mrTelnor/wizards-staff/SPEC.md

# Посох мага: техническое задание

Дата: 2026-09-03. Статус: черновик на согласовании.

## 1. Что делаем и зачем

Реквизит для игры в D&D: посох с кристаллом наверху. В кристалле спрятан цветной экран и подсветка. На рукояти кнопки с костями (d2, d4, d6, d8, d10, d12, d20, d100), четыре служебные кнопки и четыре кнопки меню.

Игрок нажимает кнопку кости (один или несколько раз), бьёт посохом об пол, в кристалле мельтешат числа, вспыхивает подсветка, и на экране остаётся результат броска.

Принципы проекта:

1. Максимально просто, но функционально.
2. Всё описано понятным языком, без жаргона там, где без него можно обойтись.
3. Повторить проект сможет любой желающий с паяльником и Arduino IDE.

Уровень исполнителя: паял немного, собирал по туториалам, код правит уверенно.

## 2. Как это работает для игрока

### 2.1. Обычный бросок

1. Нажал кнопку кости, например d20. Экран проснулся, показывает «1d20»: посох взведён. (**Изменено 2026-10-29:** было «кристалл мягко светится». Свечение кристалла теперь не связано со взводом, его включает кнопка «Свет», раздел 2.5.)
2. Ударил посохом об пол. Полторы секунды на экране бегут случайные числа, кольцо светодиодов крутится, пищалка тикает.
3. Экран показывает результат крупно: «17». Подсветка вспыхивает и гаснет до спокойного свечения. Пищалка играет короткий аккорд.
4. Результат висит на экране, пока не взведёшь новый бросок или пока экран не погаснет по таймеру.

### 2.2. Несколько костей

Каждое нажатие той же кнопки добавляет ещё одну такую же кость. Три раза d4: на экране «3d4». Удар. Результат: «3d4: 7», под ним мельче «2 + 1 + 4». Максимум 10 костей в броске; одиннадцатое нажатие возвращает к одной кости, счёт идёт по кругу (**изменено 2026-10-26**, было: на десяти счёт останавливался). Нажатие кнопки другой кости сбрасывает счётчик и взводит одну кость нового типа. Смешивать разные кости в одном броске нельзя, это сделано намеренно, чтобы управление оставалось простым.

### 2.3. Защита от случайных ударов

Удар обрабатывается только если посох взведён. После броска посох разряжается сам. Повторный удар без нажатия кнопки ничего не меняет. Взвод не спадает сам, его снимает только «Сброс» или бросок (**изменено 2026-10-28**, было: через 5 минут без удара посох разряжался сам).

**Изменено 2026-09-18:** было 30 секунд. На игре ход возвращается к игроку через несколько минут, а взводить посох принято заранее, и полминуты не хватало. Риск от длинного взвода небольшой: удар засчитывается только по пачке от десяти переключений датчика за 100 мс, то есть по настоящему стуку, а не по тому, что посох прислонили к стене.

### 2.4. Спокойное состояние

Без броска на экране часы (часы:минуты), дата и значок заряда батареи. Если часы теряли питание и время ещё не пришло с планшета, часы оранжевые и под датой надпись TIME NOT SET; пропадает при подключении планшета (**добавлено 2026-10-29**: время сборки прошивки, которое ставится часам после потери питания, выглядело как настоящее). Результат броска и меню без нажатий через 1,5 минуты сменяются часами (с 2026-10-29 время выбирается в меню). Через 2 минуты без действий экран гаснет, в том числе у взведённого посоха (**изменено 2026-10-28**, было 3 минуты). Свечение кристалла при этом остаётся: его гасит только кнопка «Свет» (**изменено 2026-10-29**, было «экран и подсветка гаснут»). Будят экран: кнопка кости (сразу взводит бросок), любая служебная кнопка или кнопка меню (только будит, своё действие не выполняет), удар по взведённому посоху (сразу бросок и результат), взвод и бросок с планшета.

### 2.5. Служебные кнопки и кнопки меню

**Изменено 2026-10-26.** Было три кнопки: «Экран» (вкл/выкл экрана, долго — настройки), «Сброс» (долго — история), «Свет»; в настройках они же работали как «следующее поле», «минус», «плюс», настраивались время, дата, яркость, звук. Пересмотрено после появления приложения: время и дата приходят с планшета, экран будит любая кнопка, за столом нужны повтор броска и удача/неудача PF2e. Разбор вариантов: `docs/assembly/service-buttons.md`, выбран вариант В плюс отдельные кнопки меню.

Служебные кнопки:

| Кнопка | Короткое нажатие | Долгое нажатие (2 с) |
|---|---|---|
| Сброс | снять взвод, счётчик костей на ноль, вернуться к часам | погасить экран |
| Повтор | взвести тот же бросок, что в прошлый раз (было 2d6 — снова 2d6) | взвести 1d20 с удачей, следующее долгое — с неудачей, и так по кругу (**изменено 2026-10-29**, было «удача → неудача → обычный») |
| Свет | режим подсветки кристалла по кругу: выкл, тускло, ярко | сменить цвет подсветки по кругу; выключенная включается тускло |
| Тихо | звук вкл/выкл | — |

Кнопки меню:

| Кнопка | Вне меню | В меню |
|---|---|---|
| ОК | открыть меню | выбрать пункт, подтвердить значение |
| ◄ | история: бросок назад | пункт назад или значение меньше |
| ► | история: бросок вперёд | пункт вперёд или значение больше |
| Отмена | — | выйти из пункта или меню без сохранения |

- **Свет (решение автора 2026-10-29).** Свечение кристалла имитирует огонь, как при включении: каждый огонёк мерцает сам по себе, переливаясь между двумя цветами палитры. Палитры по кругу: красный — оранжевый, белый — жёлтый, тёмно-зелёный — светло-зелёный, голубой — синий, фиолетовый — тёмно-фиолетовый. Гаснет только кнопкой «Свет», сон экрана и взвод его не трогают. Вспышки бросков идут поверх свечения в любом режиме, после вспышки свечение разгорается снова. Режим и палитра помнятся после выключения тумблера.
- **Удача и неудача.** Для одного d20 посох бросает два и берёт лучший (удача) или худший (неудача). Режим сбрасывается после броска, чтобы не остаться включённым случайно. При взводе на экране видно, что он включён: под «1d20» надпись FORTUNE зелёным или MISFORTUNE красным. На результате крупно итог, снизу мельче оба броска через запятую, без плюса, тем же цветом: «14, 7». Так их не спутать со слагаемыми обычного броска. Долгий «Повтор» взводит 1d20 с удачей из любого состояния, обычный d20 возвращают кнопка кости d20 или «Сброс»; короткий «Повтор» после такого броска взводит обычный 1d20 (решение автора 2026-10-29). На планшет бросок уходит с полем `adv` по плану этапа 2, задача D4.
- **Меню (решения автора 2026-10-29).** Пункты: яркость экрана (20–100 % шагом 20), громкость (тихо, средне, громко), возврат к часам (30 с, 1, 1,5, 2, 3 мин — для результата, истории и самого меню), сон экрана (1, 2, 2,5, 5 мин), тестовый режим d20 (вкл/выкл, на взводе 1d20 пометка TEST), сведения о посохе (прошивка, заряд, число бросков, номер посоха, подтверждено ли время планшетом). Сон всегда дольше возврата к часам: значения, нарушающие это, в правке серые и пропускаются. В списке ◄ ► выбирают пункт, «ОК» открывает его; в правке ◄ ► меняют значение, и оно сразу видно и слышно, «ОК» сохраняет во флеш, «Отмена» возвращает прежнее. Время и дату ставит планшет при подключении. Выход из меню: «Отмена» в списке, «Сброс» или возврат к часам без нажатий, несохранённая правка при этом отменяется (**изменено 2026-10-28**, было 20 секунд; **2026-10-29** — время выхода выбирается в меню).

### 2.6. Питание

- Тумблер на рукояти полностью отключает начинку от аккумулятора. Между играми посох выключен.
- Зарядка через разъём USB-C любым телефонным кабелем. Зарядка работает и при выключенном тумблере.
- Часы идут от своей батарейки-таблетки и не сбиваются при выключении.
- Ожидаемое время работы от одной зарядки со сборкой 4000 мА·ч: 8–10 игровых вечеров по 4 часа (оценка, замерим после сборки).

## 3. Электроника

### 3.1. Мозг: ESP32-C3 SuperMini

Плата размером 22×18 мм, программируется в Arduino IDE на том же языке, что и классические Arduino. Выбрана вместо Arduino Nano по трём причинам:

- работает на 3,3 В, как и дисплей, поэтому не нужен переходник уровней;
- памяти в сотни раз больше, анимации можно делать плавные;
- есть аппаратный генератор случайных чисел, бросок честнее программного.

### 3.2. Схема соединений

Почти всё подключается к двум шинам, поэтому проводов мало.

**Шина I2C** (два провода SDA и SCL): часы DS3231 и два расширителя портов PCF8574. Расширители нужны, потому что ножек у платы 13, а одних кнопок 16. Каждый расширитель даёт 8 входов. Первый полностью занят кнопками костей, второй — 4 служебными кнопками и 4 кнопками меню, запаса нет (**изменено 2026-10-26**, было 3 служебные кнопки и 5 входов в запасе). Понадобится ещё кнопка — третий расширитель на адрес 0x22. Кнопка подключается между входом расширителя и землёй, резисторы не нужны, подтяжка внутри чипа.

**Шина SPI**: только дисплей, 4 сигнальных провода плюс подсветка.

Распиновка ESP32-C3 SuperMini:

| Ножка | Куда идёт | Зачем |
|---|---|---|
| GPIO0 | SDA: часы DS3231, расширители PCF8574 ×2 | I2C, данные |
| GPIO1 | SCL: те же | I2C, такт |
| GPIO3 | делитель напряжения от аккумулятора (100 кОм + 100 кОм) | замер заряда |
| GPIO4 | дисплей SCL (SCK) | SPI, такт |
| GPIO6 | дисплей SDA (MOSI) | SPI, данные |
| GPIO7 | дисплей DC | команда или данные |
| GPIO10 | дисплей RES | сброс дисплея |
| GPIO5 | дисплей BLK | подсветка экрана, ШИМ; ею гасим экран |
| GPIO21 | кольцо WS2812B, вход DIN, через резистор 470 Ом | подсветка кристалла |
| GPIO20 | датчик вибрации SW-420, выход DO | удар посохом |
| GPIO8 | база транзистора S8050 через 470 Ом; транзистор коммутирует электромагнитную пищалку от 5 В, параллельно пищалке диод 1N4148 (**добавлен 2026-10-26**) | звук; в тишине на ножке ноль |
| GPIO9 | не подключается (**изменено 2026-10-26**, было INT расширителей) | кнопка BOOT: ноль при включении переводит плату в режим заливки, поэтому кнопки опрашиваются по шине без INT |
| GPIO2 | не используется | служебная ножка загрузчика, не трогаем |
| 5V, 3V3, GND | питание | см. ниже |

Если на дисплее есть ножка CS, сажаем её на землю: устройство на SPI одно.

Адреса на шине I2C: DS3231 0x68, первый PCF8574 0x20 (кости), второй 0x21 (служебные), адрес задаётся перемычками на модуле.

### 3.3. Питание

```
Аккумулятор 18650, 3,7 В, с платой защиты BMS, разъём XH2.54
   └─► модуль зарядки TP4056 с Type-C и защитой (на выходе OUT напряжение аккумулятора, 3,0–4,2 В)
          ├─ разъём Type-C выведен наружу рукояти
          └─► ТУМБЛЕР ─► повышающий преобразователь MT3608, выставлен на 5,0 В ─► шина 5 В
                             ├─ ESP32-C3, ножка 5V (плата сама делает 3,3 В)
                             ├─ кольцо WS2812B (без конденсатора, см. ниже)
                             └─ пищалка
              ножка 3V3 платы ─► дисплей, часы, расширители, датчик SW-420
```

Почему два модуля, а не один «модуль повербанка» с Type-C и выходом 5 В: платы повербанков (на чипах вроде IP5306) сами отключают выход, если нагрузка меньше примерно 50 мА дольше половины минуты. Посох в режиме сна потребляет как раз около этого, и повербанк выключал бы его посреди игры. Пара TP4056 плюс MT3608 такой самодеятельности не устраивает и стоит столько же.

Всё, что общается с платой сигналами, питается от её 3,3 В, тогда уровни совпадают. Кольцо WS2812B питается от 5 В, сигнал 3,3 В оно понимает на коротком проводе. Если будет мерцать, ставим первый светодиод «жертвенным»: питаем его через диод, чтобы снизить его напряжение до 4,3 В, и уже он передаёт сигнал дальше.

Делитель для замера заряда цепляется к аккумулятору до тумблера. Ток через делитель 20 мкА, батарею он не сажает.

**Изменено 2026-10-29:** конденсатор 1000 мкФ у кольца убран. При включении тумблера пустой конденсатор заряжался из аккумулятора напрямую через MT3608, бросок тока выбивал защиту TP4056, и посох от аккумулятора не включался. Для 12 светодиодов на коротких проводах он не нужен. Если кольцо замерцает на длинных проводах в собранном посохе, конденсатор ставится через резистор 470 Ом с диодом 1N4148, схема в `hardware/wiring.md`, раздел «Питание».

### 3.4. Список компонентов

Цены ориентировочные по Ozon и Wildberries на сентябрь 2026, разброс у продавцов до двух раз.

| № | Что | Что вбивать в поиск | Цена, ₽ |
|---|---|---|---|
| 1 | Плата ESP32-C3 SuperMini | `ESP32-C3 SuperMini` | 250–400 |
| 2 | Дисплей 1,54" IPS 240×240 ST7789 SPI | `дисплей 1.54 ST7789 240x240 SPI IPS` | 500–900 |
| 3 | Модуль часов DS3231 с батарейкой | `DS3231 модуль часов mini` | 150–300 |
| 4 | Расширитель портов PCF8574, 2 шт | `PCF8574 модуль расширения I2C` | 100–200 за шт |
| 5 | Кольцо адресных светодиодов WS2812B, 12 шт | `WS2812B кольцо 12 светодиодов` | 150–300 |
| 6 | Датчик вибрации SW-420 | `SW-420 датчик вибрации модуль` | 80–150 |
| 7 | Пассивная электромагнитная пищалка 12 мм (12085, 3–5 В) | `пассивный зуммер 12085 5V` | 50–100 |
| 7а | Транзистор NPN S8050 или 2N2222 (усилитель для пищалки) | `транзистор S8050 TO-92` | 50–100 за пачку |
| 7б | Диод 1N4148 параллельно пищалке (добавлен 2026-10-26) | `диод 1N4148` | 50 за пачку |
| 7в | Гребёнка «папа» 2,54 мм под шину земли кнопок (добавлена 2026-10-26) | `гребёнка PLS 2.54` | 50 |
| 8 | Модуль зарядки TP4056 с Type-C и защитой | `TP4056 Type-C с защитой` | 50–150 |
| 8а | Повышающий преобразователь MT3608 (3,7 → 5 В, до 2 А) | `MT3608 повышающий преобразователь` | 50–150 |
| 9 | Аккумулятор 18650 3,7 В 4000 мА·ч: две банки в параллель под одной оболочкой, с BMS и разъёмом XH2.54, сборка 66×37×19 мм | `аккумулятор 18650 3.7V 4000 с защитой XH2.54` | 500–900 |
| 10 | Выключатель питания на ток не меньше 2 А: тумблер MTS-102 или крупный ползунковый SS-22F | `тумблер MTS-102`, `ползунковый переключатель 3A` | 50 |
| 11 | Тактовые кнопки 12×12 мм с колпачками, 16 шт (набор; было 11 до 2026-10-26) | `кнопки тактовые 12x12 набор колпачки` | 150–300 |
| 12 | Резисторы 100 кОм ×2, 470 Ом ×2 (кольцо и база транзистора); конденсатор 1000 мкФ 16 В — не ставится с 2026-10-29, нужен только как запасной вариант, см. 3.3 | `набор резисторов`, `конденсатор 1000 мкФ` | 100–200 |
| 13 | Ответный разъём к аккумулятору, 2 pin с проводами, того же типа, что на аккумуляторе | `SM2.54 2pin разъём с проводом` или `XH2.54 2pin разъём с проводом` | 50 |
| 14 | Монтажный провод 0,2–0,3 мм², термоусадка, провода Dupont | `провод МГТФ`, `dupont провода набор` | 200–300 |
| 15 | Макетная плата для прототипа | `breadboard 830` | 200–300 |

Итого электроника: примерно 3–5 тысяч рублей.

Инструменты (есть в наличии): паяльник 40–60 Вт с тонким жалом, припой с флюсом, мультиметр, термоклей, бокорезы, кабель USB-C, компьютер с Arduino IDE.

## 4. Корпус

**Изменено 2026-10-22: корпус делается без 3D-печати**, из ПВХ-труб и фитингов ручным инструментом. Везде, где ниже сказано «напечатанная деталь», берётся вариант без принтера: оправа — ПВХ-муфта 25→32 мм (раздел 4.3), рукоять — отрезок ПВХ-трубы 50 мм с двумя переходниками 50→25 (раздел 4.5). Картридж под дисплей и кольцо (раздел 4.2) без печати ещё не продуман, решается в задаче 14 плана. Фотополимерная печать кристалла отпадает, остаётся заливка шара в молд.

### 4.1. Общая компоновка

Посох состоит из трёх частей, соединённых проводами внутри трубы.

```
   ┌─────────┐
   │ КРИСТАЛЛ│  экран + кольцо светодиодов внутри, открыт снизу
   └────┬────┘
   ┌────┴────┐
   │ ОПРАВА  │  держит кристалл, провода уходят в трубу
   └────┬────┘
        │
        │       стержень: ПВХ-труба 25 мм, длина 120–150 см
        │
   ┌────┴────┐
   │ РУКОЯТЬ │  муфта на трубе: вся электроника, 16 кнопок, тумблер, Type-C
   └────┬────┘
        │
        │
       ═╧═      резиновый наконечник
```

Общая длина подбирается под рост: верх кристалла на уровне глаз или чуть выше. Рукоять ставится там, где кисть лежит при ударе об пол, обычно на высоте груди. Кнопки под большим пальцем.

### 4.2. Кристалл

Кристалл полый, открытый снизу. Электроника в смолу не заливается: залитое не починить, а тепло застывающей эпоксидки и её усадка могут погубить дисплей.

Два способа изготовления, на выбор:

- **Фотополимерная печать** прозрачной смолой: стенка 2–3 мм, полость внутри, отверстие снизу под картридж. Самый простой и ремонтопригодный путь. Передняя грань плоская и полируется до прозрачности, остальные грани можно оставить матовыми, они будут рассеивать подсветку.
- **Заливка эпоксидкой в силиконовый молд.** Полость делается вставкой: в молд до заливки ставится напечатанный или вырезанный сердечник, смазанный разделителем, после застывания сердечник вынимается.

**Выбрано (2026-09-11): шар 120 мм**, куплен силиконовый молд «хрустальный шар 120 мм». Кристалл становится хрустальным шаром, как у гадалки. Что из этого следует:

- **Шар должен быть полым, стенка 8–12 мм.** Сплошной шар 120 мм это около 900 г смолы на макушке полутораметрового посоха, слишком тяжело и опасно при заливке: большая масса эпоксидки перегревается, желтеет и трескается. Полый шар со стенкой 10 мм весит около 450 г, заливается в один-два слоя. Внутренняя полость около 100 мм в диаметре, картридж с дисплеем и кольцом в неё входит свободно.
- **Отверстие снизу под картридж не меньше 50 мм.** У молда для шара заливочное отверстие обычно 20–30 мм. Его нужно расширить до 50–55 мм острым ножом, силикон режется легко. Расширенное отверстие оказывается внизу шара и скрывается в оправе.
- **Сердечник для полости:** шар диаметром 100 мм из пенопласта (продаётся как заготовка для рукоделия), обтянутый пищевой плёнкой или скотчем и смазанный разделителем, на ножке диаметром 50 мм, которая выходит через отверстие молда и центрирует сердечник. После застывания пенопласт вынимается через отверстие: ломается пальцами или растворяется ацетоном.
- **Оптика.** Толстая стенка с воздухом внутри слегка увеличивает изображение, как лупа, цифры читаются. Сплошной шар был бы сильной линзой и искажал бы экран, ещё одна причина делать полость. Дисплей стоит вплотную к передней стенке, отступ 3–5 мм.
- **Смола:** эпоксидка для заливки «ювелирная» или «для толстых слоёв», прозрачная, с медленным отвердителем. Заливать в два слоя по половине, каждый до 15–20 мм толщиной, между слоями сутки. Готовый шар шлифуется по шву молда и полируется.

Прежний вариант, гранёный кристалл 8–10 см печатью или заливкой, остаётся запасным.

Внутри кристалла картридж: напечатанная рамка, в которой стоит дисплей лицом к передней стенке, а под ним кольцо светодиодов, светящее вверх в толщу шара. Для шара картридж проектируется под полость 100 мм и отверстие 50 мм: дисплей на высоте центра шара, кольцо у основания. Картридж вставляется снизу через оправу и фиксируется винтом или защёлкой. Провода от картриджа: 7 на дисплей (5 сигнальных плюс питание) и 3 на кольцо.

### 4.3. Оправа

Напечатанная деталь: сверху чаша под шар (или «когти», как у настоящих посохов), которая закрывает отверстие 50 мм и держит шар за нижнюю треть, снизу пробка в трубу. Шар в чаше сажается на прозрачный силиконовый герметик или эпоксидку, чтобы не вылетел при ударе об пол. Сквозное отверстие под провода. Если печати нет, роль оправы играет ПВХ-муфта 25→32 мм, обмотанная шпагатом или кожей.

### 4.4. Стержень

Жёсткая ПВХ-труба 25 мм (электромонтажная гладкая) длиной 120–150 см. Легко пилится, сверлится, красится. Декор: обмотка шпагатом, кожей, шпаклёвка под кору дерева, покраска. Альтернативы: алюминиевая трубка (тяжелее, звонче стук) или деревянная палка с высверленным каналом (красиво, но сверлить сквозной канал полтора метра трудно).

Внизу резиновый наконечник для трости под диаметр трубы: стук глухой, пол целый, датчик вибрации всё равно ловит удар через трубу.

### 4.5. Рукоять

Напечатанный корпус из двух половинок, длина 20–24 см, диаметр 50–55 мм. Он не надевается на трубу, а заменяет её отрезок: труба в этом месте разрезана, её концы входят в гнёзда корпуса сверху и снизу на глубину 30 мм, половинки стягиваются винтами. Так внутри остаётся место под аккумуляторную сборку 66×37×19 мм: рядом с целой трубой 25 мм она не поместилась бы. Посох в этом месте получается толстым, это осознанный выбор в пользу ёмкости. В корпусе:

- 8 отверстий под кнопки костей в ряд, рядом подпись (d2, d4, ...) или цветные колпачки;
- 4 отверстия под служебные кнопки, отдельной группой, чтобы не путать с костями;
- 4 отверстия под кнопки меню крестом: ОК, ◄, ►, Отмена (**изменено 2026-10-26**, кнопок меню не было);
- окно под разъём Type-C с заглушкой;
- вырез под тумблер, утопленный, чтобы не задеть в игре;
- внутри ложе под аккумуляторную сборку 66×37×19 мм и полки под платы.

Без принтера: отрезок ПВХ-трубы 50 мм с двумя переходниками 50→25 по концам, отверстия сверлятся, платы садятся на термоклей.

Датчик вибрации крепится внутри рукояти жёстко к трубе, вибрация от удара доходит по трубе. Чувствительность настраивается винтом на модуле.

## 5. Прошивка

### 5.1. Состояния

```
   ┌──────────┐  кнопка кости   ┌──────────┐    удар     ┌──────────┐
   │ ОЖИДАНИЕ ├─────────────────►│ ВЗВЕДЁН  ├────────────►│  БРОСОК  │
   │  (часы)  │◄─────────────────┤  «3d6»   │             │ анимация │
   └────┬─────┘  5 мин без удара └──────────┘             └────┬─────┘
        │        или «Сброс»                                   │
        │ 3 мин                                                ▼
        ▼                                                ┌──────────┐
   ┌──────────┐  любая кнопка                            │РЕЗУЛЬТАТ │
   │   СОН    ├──────────────► в ОЖИДАНИЕ или ВЗВЕДЁН    │ «3d6: 11»│
   │экран выкл│                                          └──────────┘
   └──────────┘                        РЕЗУЛЬТАТ ──3 мин──► СОН
                                       РЕЗУЛЬТАТ ──кнопка кости──► ВЗВЕДЁН

   «ОК» из ОЖИДАНИЯ или РЕЗУЛЬТАТА ──► МЕНЮ ──«Отмена»──► обратно
```

### 5.2. Правила

- **Кнопки.** Дребезг гасится программно: нажатие засчитывается, если кнопка держится 30 мс. Долгое нажатие: 2 секунды.
- **Удар.** Датчик SW-420 даёт короткий импульс. Учитываем его только в состоянии ВЗВЕДЁН и не раньше чем через 300 мс после последнего нажатия кнопки, чтобы само нажатие не сработало как удар. После броска датчик игнорируется до нового взвода.
- **Случайное число.** Аппаратный генератор ESP32. Для NdX бросаем N раз отдельно, суммируем и запоминаем каждую кость. d100 даёт 1–100.
- **Анимация броска.** Полторы секунды: числа на экране меняются сначала быстро, потом всё медленнее и останавливаются на результате. Кольцо крутится «бегущим огоньком» с той же скоростью. Пищалка тикает на каждой смене числа, в конце короткий аккорд. **Изменено 2026-10-22:** экран повторяет барабан из приложения на планшете — 1,1 секунды, суммы выезжают снизу вверх, бледные, пока крутится, слагаемые спрятаны до остановки.
- **Результат.** Крупно сумма. Если костей больше одной, сверху «3d6», снизу мельче слагаемые. Для одного d20 дополнительно: 20 подсвечивается золотым и кольцо вспыхивает, 1 подсвечивается красным.
- **История.** Последние 20 бросков из истории во флеш, списком по 4 на экран, свежие сверху: время, что бросали, итог, под ним мелко слагаемые. Переживают выключение тумблера. ◄ с любого экрана открывает историю, дальше ◄ и ► двигают выделение по одной строке (◄ к старым, ► к новым), выбранная строка на тёмно-синем фоне, список сдвигается вслед за выделением по одной строке; ► на самом свежем броске, «Отмена», «Сброс» или 1,5 минуты без нажатий возвращают на взвод или к часам, взвод не снимается (**изменено 2026-10-29**, было: 5 бросков в оперативной памяти по одному, только с экрана часов, терялись при выключении; до 2026-10-26 — по долгому «Сброс»).
- **Часы.** Читаем DS3231 раз в секунду. Настройка через меню.
- **Заряд.** Читаем напряжение аккумулятора раз в 10 секунд через делитель, переводим в проценты: 4,2 В это 100 %, 3,3 В это 0 %. Значок батареи в углу экрана. Ниже 5 % значок мигает.
- **Сон.** Подсветка экрана гаснет через 2 минуты без действий (**изменено 2026-10-28**, было 3). Кольцо сон не трогает: свечение гасит только «Свет» (**изменено 2026-10-29**, раньше гасло и кольцо). Плата продолжает слушать кнопки. Глубокий сон платы с пробуждением по кнопке: возможное улучшение позже, если автономности не хватит.

### 5.3. Среда и библиотеки

- Arduino IDE 2.x, пакет плат «esp32 by Espressif», плата «ESP32C3 Dev Module».
- Дисплей: Adafruit GFX + Adafruit ST7789.
- Часы: RTClib (Adafruit).
- Кольцо: Adafruit NeoPixel.
- Расширители: Adafruit PCF8574.

Код разбивается на небольшие файлы по смыслу: настройки ножек, кнопки, экран, кости, подсветка, звук, главный цикл. Каждый файл делает одно дело, каждая функция снабжена комментарием, что она делает и зачем.

## 6. Порядок работы

1. Закупка компонентов по списку из раздела 3.4.
2. Сборка на макетной плате проводами Dupont, без пайки. Проверка каждого модуля отдельно: дисплей, часы, кольцо, кнопки, датчик, пищалка.
3. Прошивка: сначала минимальная (кнопка, удар, число), потом анимация, часы, настройки, история.
4. Тесты на столе: серия из 100 бросков d6 и d20, проверка равномерности «на глаз», проверка ложных срабатываний датчика.
5. Изготовление корпуса: кристалл, оправа, рукоять, труба.
6. Пайка начисто, укладка в посох, финальная проверка.
7. Замер времени работы от одной зарядки, запись в журнал.

## 7. Что осознанно не делаем

- Смешанные броски (d6 + d4 в одном ударе).
- Модификаторы к броску (+3 и подобное).
- Wi-Fi, Bluetooth, приложение на телефоне.
- Голос и запись звуков: только пищалка.
- Кнопка в наконечнике и акселерометр: выбран датчик вибрации как самый простой.

## 7а. Этап 2: связь с планшетом и приложение

**Изменено 2026-09-19:** раздел назывался «Идеи на потом (этап 2, после запуска посоха)» и описывал всё нижеследующее как незапланированное. С 2026-09-17 этап 2 идёт параллельно основной сборке, наполовину сделан, и цифры в старой редакции успели устареть. Рабочий план этапа лежит в `docs/ПЛАН-APP.md`.

### Решения

- **Связь с планшетом по Bluetooth.** У ESP32-C3 Bluetooth встроен, железо докупать не нужно. Посох отдаёт события бросков и заряд, принимает время и настройки. Расход батареи при подключённом планшете плюс 10–15 мА.
- **Приложение: сразу APK** (решение от 2026-09-08), без промежуточной веб-страницы. Цель: Android и HarmonyOS до версии 4 включительно (они запускают APK). HarmonyOS NEXT (5 и новее) APK не поддерживает, для неё потребовалось бы отдельное приложение на ArkTS; отдельный пункт «если понадобится». Web Bluetooth страница остаётся необязательной страховкой для отладки протокола.
- **Основное устройство — планшет** HUAWEI MatePad SE 11 (HarmonyOS 2.0, то есть Android 10, без сервисов Google). Проверка на телефонах отложена до готовности листа персонажа (решение от 2026-09-19): основная разработка — посох и планшет.
- **Защита связи PIN-кодом** (решение от 2026-09-18): четыре цифры, без PIN посох не отвечает и сам разрывает связь через 10 секунд, одновременное подключение только одно, при подборе нарастающая блокировка. PIN живёт во флеш посоха и меняется из приложения.
- **Обновление прошивки по Bluetooth** (решение от 2026-09-18) выделено в отдельный этап, который делается после сборки посоха. Причина: наружу рукояти выведен только разъём зарядки, свой USB платы остаётся внутри, и после закрытия рукояти обновление по воздуху — единственный способ что-то поправить.
- **Функции приложения:** полная история бросков с подписями, синхронизация времени с планшета, листы персонажей D&D и Pathfinder, модификаторы к броскам, **переназначение кнопок посоха**: любой из 8 кнопок задаётся число граней (например d3 или d1000), служебным кнопкам назначаются другие действия (например «перебросить последний»).
- **Следствие для корпуса:** колпачки кнопок цветные, без цифр, чтобы переназначение не спорило с надписями; соответствие цвета кости показывать на экране при нажатии.

### Что уже работает (прошивка 0.4.2 на 2026-09-19)

- Посох виден как `WizardsStaff`, поднимает сервис Nordic UART и стандартный Battery Service. Сообщения — по строке JSON на каждое.
- Команды: `info`, `time`, `arm`, `disarm`, `roll`, `hist`, `map`.
- История бросков во флеш: кольцевой файл в LittleFS на 1500 записей. Номера бросков сквозные и переживают выключение, у посоха есть постоянный номер `staffId`. Приложение догружает пропущенное командой `hist`, порциями по 50 записей.
- Таблица костей по кнопкам хранится во флеш и меняется командой `map`.
- Кости до d1000, как и обещано в старой редакции этого раздела.
- Служебные сообщения посоха приходят в приложение единым журналом: время, модуль, уровень, текст.
- Приложение (Kotlin, Compose, minSdk 29): подключение, лента бросков, экран логов с отправкой команд и сохранением в файл.

### Что осталось

Защита PIN-кодом, база бросков в приложении с подписями, настройки посоха, статистика, листы персонажей и действия, преимущество и помеха, таймер хода, обновление прошивки по Bluetooth. Подробности и порядок — в `docs/ПЛАН-APP.md`.

## 8. Структура репозитория

```
wizards-staff/
  README.md          обзор проекта, как играть, как повторить
  SPEC.md            этот документ
  JOURNAL.md         журнал сборки: что сделали, что не заработало, как починили
  firmware/          код для Arduino IDE, скетч wizards_staff
  hardware/          спецификация компонентов (bom.md), распиновка (wiring.md), схема, фото макета
  enclosure/         размеры, модели для печати (STL), фото корпуса
  docs/              служебные материалы, в git не входят
```
