mrTelnor/wizards-staff/hardware/bom.md

# Посох мага: закупки

Ссылки и цены по факту покупки. Ориентиры и поисковые слова: [SPEC.md](../SPEC.md), раздел 3.4.

Статусы: не заказано, заказано, получено.

## Электроника

| № | Что | Где куплено (ссылка) | Кол-во | Цена, ₽ | Статус | Проверить |
|---|---|---|---|---|---|---|
| 1 | ESP32-C3 SuperMini Wi-Fi Bluetooth (первый лот https://ozon.ru/t/5DRsU0M закончился) | https://ozon.ru/t/qtwUUhx | 1 | | получено | мигалка залита, Serial работает; заводская прошивка уходила в цикл сброса, заливать первый раз из режима BOOT |
| 2 | Дисплей 1,54" IPS 240×240, модуль ST7789 Ver 1.1, 8 pin: GND VCC SCL SDA RST DC CS BL | https://ozon.ru/t/l1xMlUN | 1 | | получено | гребёнка в комплекте, припаять самому |
| 3 | Часы DS3231 GSMIN | https://ozon.ru/t/wEVthoS | 1 | | получено | проверить, есть ли батарейка, иначе купить CR2032 |
| 4 | Расширитель PCF8574T I2C | https://ozon.ru/t/QWX4wPA | **2** | | получено | перемычки адреса A0–A2 на плате |
| 5 | Кольцо WS2812B 12 LED | https://ozon.ru/t/8Mj053o | 1 | | получено | припаять 3 провода: 5V, GND, DI (не DO) |
| 6 | Датчик вибрации SW-420 | https://ozon.ru/t/D4hXyOb | 1 | | получено | |
| 7 | Пассивный зуммер 12×8,5 мм, 42 Ом, 3–12 В, 10 шт | https://ozon.ru/t/fBTrUhP | 1 упак. | | получено | |
| 7а | Транзистор NPN S8050D, корпус TO-92 | https://ozon.ru/t/j70qy2p | 1 (пачка) | | получено | резистор 470 Ом в базу уже есть в позиции 12б |
| 8 | Модуль зарядки TP4056 Type-C с защитой | https://ozon.ru/t/9oYLj16 | 1 | | получено | |
| 8а | Повышающий преобразователь MT3608 | https://ozon.ru/t/9oYy1zH | 1 | | получено | |
| 9 | Аккумулятор 18650 3,7 В 4000 мА·ч, две банки, BMS, XH2.54 | https://ozon.ru/t/hiSuw5o | 1 | | получено | мультиметром на разъёме: 3,5–4,0 В, плюс на красном |
| 10 | Выключатель питания (по характеристикам тумблер 6 А, отверстие 6 мм; в названии «кулисный») | https://ozon.ru/t/5DRsDMw | 1 | | получено | проверено 2026-10-22: тумблер, двухпозиционный; отверстие в рукояти 6 мм (по характеристикам, при сверлении сверить с гайкой) |
| 11 | Тактовые кнопки 12×12×7,3 мм, 25 шт + 25 колпачков 5 цветов | https://ozon.ru/t/6lAzRP5 | 1 упак. | | получено | проверено 2026-10-22: без фиксации, возвращаются сами |
| 12а | Резистор 100 кОм 0,25 Вт 1 %, 10 шт | https://ozon.ru/t/mUrBULR | 1 упак. | | получено | |
| 12б | Резистор 470 Ом 0,25 Вт 1 %, 10 шт | https://ozon.ru/t/mUrBOjf | 1 упак. | | получено | |
| 12в | Конденсатор 1000 мкФ 16 В, 3 шт | https://ozon.ru/t/mUrImPE | 1 упак. | | получено | у кольца не ставится (2026-10-29): выбивал защиту TP4056 при включении; запасной вариант через 470 Ом и 1N4148, hardware/wiring.md |
| 13 | Кабель JST XH2.54 2 pin 10 см + разъём на плату, 2 шт | https://ozon.ru/t/WcpKc4E | 1 упак. | | получено | |
| 14а | Dupont 20 см, 3 вида по 40 шт | https://ozon.ru/t/EI26bNG | 1 упак. | | получено | |
| 14б | Провод МГШВ 0,35 мм², 7 цветов, 21 м | https://ozon.ru/t/J5eNutV | 1 набор | | получено | |
| 14в | Провод ПВАМ 0,75 мм², 2×5 м | https://ozon.ru/t/dwFqdxz | 1 упак. | | получено | |
| 14г | Термоусадка 2, 3 и 6–8 мм | | | | получено | |
| 15 | Макетная плата 400 точек, 3 шт | https://ozon.ru/t/l1xLITL | 3 | | получено | |
| 16 | Диод 1N4148, 10 шт | https://ozon.ru/t/D4JkHjr | 1 упак. | | получено | параллельно зуммеру, полоска (катод) к 5V |
| 17 | Гребёнка «папа» 2,54 мм PLS-40, прямая, 40 штырей, 10 шт | https://ozon.ru/t/IYwbvUC | 1 упак. | | получено | шины питания и земли: GND 30, 5 В 7, 3,3 В 7 штырей (hardware/wiring.md) |

## Корпус (покупается на этапе C, без 3D-печати — решение 2026-10-22)

| Что | Где | Цена, ₽ | Статус |
|---|---|---|---|
| ПВХ-труба 25 мм, 1,5 м | | | не заказано |
| Рукоять без печати: отрезок ПВХ-трубы 50 мм около 25 см и два переходника 50→25, подобрать по факту (SPEC, раздел 4.5) | | | не заказано |
| Оправа без печати: ПВХ-муфта 25→32 мм (SPEC, раздел 4.3) | | | не заказано |
| Резиновый наконечник для трости 25 мм | | | не заказано |
| Силиконовый молд «хрустальный шар» 120 мм | https://ozon.ru/t/5DlQLcc | | заказано |
| Эпоксидная смола прозрачная для заливки толстых слоёв, около 600 г с отвердителем | | | не заказано |
| Шар из пенопласта 100 мм (сердечник для полости) | | | не заказано |
| Разделитель для силиконовых форм (или вазелин, или восковой спрей) | | | не заказано |
| Наждачка 400–2000 и полировальная паста для шва шара | | | не заказано |
| Винты М3 ×4 для рукояти | | | не заказано |
