mrTelnor/wizards-staff/hardware/wiring.md

# Распиновка и подключение модулей

Все номера ножек продублированы в `firmware/wizards_staff/config.h`. Если меняется подключение, меняется и он.

Полная схема соединений в картинке: [schematic/wiring.svg](schematic/wiring.svg). Отдельно блок питания: [schematic/power.svg](schematic/power.svg). Земля (GND) у всех модулей общая, это первый провод к каждому модулю.

## Ножки ESP32-C3 SuperMini

Подписи ножек напечатаны на нижней стороне платы. Со стороны подписей, USB вверх: левый ряд `5V, G, 3.3, 4, 3, 2, 1, 0`, правый ряд `5, 6, 7, 8, 9, 10, 20, 21`. На макетке плата лежит чипом вверх, поэтому ряды меняются местами: ряд `5V` оказывается справа. Так же плата нарисована на схемах: снизу, как на фото.

| Ножка | Куда идёт | Зачем |
|---|---|---|
| GPIO0 | SDA: цепочка PCF8574 №1 → PCF8574 №2 → часы DS3231 | I2C, данные |
| GPIO1 | SCL: та же цепочка | I2C, такт |
| GPIO3 | делитель напряжения от аккумулятора (100 кОм + 100 кОм) | замер заряда |
| GPIO4 | дисплей SCL (SCK) | SPI, такт |
| GPIO5 | дисплей BL (BLK) | подсветка экрана, ШИМ |
| GPIO6 | дисплей SDA (MOSI) | SPI, данные |
| GPIO7 | дисплей DC | команда или данные |
| GPIO8 | база транзистора S8050 через 470 Ом, транзистор коммутирует пищалку от 5 В | звук; на этой же ножке синий светодиод платы, в тишине он горит |
| GPIO9 | не подключать | кнопка BOOT платы: ноль на ней при включении переводит плату в режим заливки. Поэтому INT расширителей сюда не ведём (решение 2026-10-26), кнопки опрашиваются по шине |
| GPIO10 | дисплей RST (RES) | сброс дисплея |
| GPIO20 | датчик вибрации SW-420, выход DO | удар посохом |
| GPIO21 | кольцо WS2812B, вход DI, через резистор 470 Ом | подсветка кристалла |
| GPIO2 | не используется | служебная ножка загрузчика, не трогаем |
| 5V, 3V3, GND | питание | см. ниже |

Адреса на шине I2C: DS3231 0x68, первый PCF8574 0x20 (кости), второй 0x21 (служебные и меню). Адрес задаётся перемычками A0–A2 на модуле. Чипы на наших модулях — PCF8574T (проверено 2026-10-26); у PCF8574AT адреса были бы 0x38 и 0x39.

## Дисплей 1,54" ST7789

На плате модуля 8 контактов. Устройство на SPI одно, поэтому CS сажаем на землю.

| Дисплей | ESP32-C3 |
|---|---|
| GND | GND |
| VCC | 3V3 |
| SCL | GPIO4 |
| SDA | GPIO6 |
| RST | GPIO10 |
| DC | GPIO7 |
| CS | GND |
| BL | GPIO5 |

## Расширители PCF8574 и кнопки

Шина I2C собрана цепочкой (решение 2026-10-27): плата → расширитель №1 → расширитель №2 → часы. У модуля PCF8574 с одного края входная гребёнка, с другого выходное гнездо, по которому те же GND, VCC, SDA, SCL и INT идут дальше. К плате провода идут только от входа первого расширителя, остальные модули питаются и общаются через него.

| Вход PCF8574 №1 (0x20, кости) | ESP32-C3 |
|---|---|
| GND | GND |
| VCC | 3V3 |
| SDA | GPIO0 |
| SCL | GPIO1 |
| INT | не подключать |

Расширитель №2 (0x21) втыкается входной гребёнкой в выходное гнездо №1. Часы подключаются к выходному гнезду №2, см. раздел «Часы DS3231».

На каждом модуле стоят подтяжки SDA и SCL по 1 кОм (резисторы «102»); с двумя модулями и часами шина работает. Если расширитель начнёт пропадать, выпаять подтяжки на модуле №2.

Если отвалится разъём между модулями, пропадёт всё, что стоит за ним: вынули №2 — пропали и часы.

Кнопка подключается между входом расширителя и GND, резисторы не нужны, подтяжка внутри чипа. Берутся две ножки кнопки по диагонали. Земля всех 16 кнопок идёт на общую шину GND, см. раздел «Шины питания и земли».

| Расширитель | Вход | Кнопка |
|---|---|---|
| 0x20 (кости) | P0 | d2 |
| 0x20 | P1 | d4 |
| 0x20 | P2 | d6 |
| 0x20 | P3 | d8 |
| 0x20 | P4 | d10 |
| 0x20 | P5 | d12 |
| 0x20 | P6 | d20 |
| 0x20 | P7 | d100 |
| 0x21 (служебные и меню) | P0 | Сброс |
| 0x21 | P1 | Повтор |
| 0x21 | P2 | Свет |
| 0x21 | P3 | Тихо |
| 0x21 | P4 | ОК |
| 0x21 | P5 | ◄ Назад |
| 0x21 | P6 | ► Вперёд |
| 0x21 | P7 | Отмена |

Что делает каждая кнопка: SPEC, раздел 2.5.

## Датчик вибрации SW-420

| SW-420 | ESP32-C3 |
|---|---|
| GND | GND |
| VCC | 3V3 |
| DO | GPIO20 |

Чувствительность настраивается винтом на модуле.

## Кольцо WS2812B

| Кольцо | Куда |
|---|---|
| GND | GND |
| 5V | шина 5 В |
| DI | GPIO21 через резистор 470 Ом |

Площадку DO не трогать, это выход на следующее кольцо.

Конденсатора у кольца нет (**изменено 2026-10-29**, был 1000 мкФ 16 В между 5V и GND). С ним посох не включался от аккумулятора: пустой конденсатор при включении тумблера заряжается из аккумулятора напрямую через дроссель и диод MT3608, бросок тока в несколько ампер выбивает защиту TP4056, на её выходе остаётся около 1 В. Для 12 светодиодов на коротких проводах конденсатор не нужен. Если кольцо начнёт мерцать на длинных проводах в собранном посохе — ставить его через резистор и диод, раздел «Питание».

GPIO21 у ESP32-C3 — это ещё и выход TX порта UART0. При включении загрузчик платы печатает туда служебный текст, и кольцо на долю секунды загорается случайными цветами. Это нормально: прошивка (с 0.9.0) первым делом гасит кольцо. Если кольцо горит постоянно, значит, прошивка до него не дошла или в ней нет кольца.

## Пищалка через транзистор

```
GPIO8 ──[ 470 Ом ]──► база (B) транзистора S8050
                       эмиттер (E) ──► GND
                       коллектор (C) ──► минус пищалки
шина 5 В ─────────────► плюс пищалки

диод 1N4148 параллельно пищалке: полоска (катод) к плюсу, к 5 В; другой конец к минусу
```

Диод гасит обратный выброс катушки, когда транзистор закрывается. Перевёрнутый диод закоротит пищалку.

В тишине на GPIO8 должен быть ноль: единица держит транзистор открытым, через катушку идёт около 120 мА. Прошивка (с 0.8.0) ставит ноль первой строкой `setup()`. Короткий щелчок при включении питания нормален. GPIO8 — служебная ножка загрузки: при входе в режим заливки кнопкой BOOT провод к базе транзистора отсоединить, заливке через Arduino IDE по USB он не мешает.

Ножки S8050 в корпусе TO-92, если смотреть на плоскую сторону с надписью: слева эмиттер, в центре база, справа коллектор.

## Часы DS3231

Часы стоят последними в цепочке I2C: четыре провода от выходного гнезда расширителя №2.

| DS3231 | Выход PCF8574 №2 |
|---|---|
| GND | GND |
| VCC | VCC (это 3V3 платы, пришедшие по цепочке) |
| SDA | SDA |
| SCL | SCL |
| — | INT не подключать |

Порядок контактов у часов и у расширителя разный, поэтому напрямую часы в гнездо не воткнуть: нужны провода «мама-мама» или пайка. Соединять по подписям на модулях, а не по положению контактов.

Батарейка CR2032 или LIR2032 в держателе модуля.

## Питание

Схема в картинке: [schematic/power.svg](schematic/power.svg).

```
Аккумулятор 18650, 3,7 В, с BMS, разъём XH2.54
   └─► TP4056 с Type-C и защитой: B+ / B−
          ├─ разъём Type-C выведен наружу рукояти, зарядка работает при выключенном тумблере
          └─► OUT+ ─► ТУМБЛЕР ─► IN+ MT3608 (выставлен на 5,0 В) ─► OUT+ = шина 5 В
                                                                     ├─ ESP32-C3, ножка 5V
                                                                     ├─ кольцо WS2812B
                                                                     └─ пищалка
              OUT− TP4056 ─► IN− MT3608 ─► OUT− = общая GND
              ножка 3V3 платы ─► дисплей, цепочка расширителей с часами, датчик SW-420
```

Делитель заряда: 100 кОм от B+ (плюс аккумулятора, до тумблера) к GPIO3, ещё 100 кОм от GPIO3 к GND.

MT3608 настраивать до подключения к плате: аккумулятор на IN, мультиметр на OUT, крутить подстроечник до 5,00–5,05 В, зафиксировать винт каплей лака. Винт не трогать, когда к выходу подключена плата. Замер на нашем посохе: 5,05 В без нагрузки, 5,01 В под нагрузкой.

Тумблер двухпозиционный, 6 А: используются средняя и одна крайняя ножки.

Если на OUT TP4056 вдруг 1–2 В при живом аккумуляторе — это сработала защита модуля: при включении тумблера слишком большой бросок тока. Сбрасывается зарядкой в Type-C или переподключением аккумулятора.

**2026-10-29:** с полной нагрузкой защита срабатывала при каждом включении: 0,9 В на OUT при 4,1 В на аккумуляторе, кольцо коротко моргало белым, и всё. Причина — конденсатор 1000 мкФ у кольца, без него посох включается. Большие ёмкости на шине 5 В подключать только через медленный заряд:

```
шина 5 В ──┬── 470 Ом ──┬── (+) 1000 мкФ (−) ── GND
           │            │
           └──◄|── 1N4148 ┘
            катод     анод
          (полоска к шине 5 В)
```

Резистор заряжает конденсатор за полсекунды током не больше 10 мА, диод отдаёт заряд обратно в шину, когда нагрузка резко берёт ток. Перенос тумблера на сторону 5 В оставлен последним вариантом: MT3608 тогда работает и при выключенном посохе и разряжает аккумулятор между играми.

## Шины питания и земли

Решение 2026-10-27. Каждая шина — отрезок гребёнки «папа» 2,54 мм (PLS-40), короткие ножки спаяны лужёной проволокой, на длинные штыри надеваются или припаиваются провода. Шин три, GND одна общая для всего посоха, включая кнопки. Часы стоят в цепочке за расширителями (раздел «Часы DS3231»), отдельных контактов им не нужно.

**GND: 25 занято + 5 запасных = 30 штырей**

| № | Что |
|---|---|
| 1 | MT3608 OUT− (отсюда приходит земля) |
| 2 | ESP32-C3, ножка G |
| 3 | дисплей GND |
| 4 | дисплей CS |
| 5 | вход PCF8574 №1, GND (дальше по цепочке №2 и часы) |
| 6 | SW-420 GND |
| 7 | кольцо GND |
| 8 | эмиттер S8050 |
| 9 | нижний резистор делителя заряда 100 кОм |
| 10–17 | 8 кнопок костей |
| 18–25 | 8 служебных кнопок и кнопок меню |
| 26–30 | запас |

**5 В: 4 занято + 3 запасных = 7 штырей**

| № | Что |
|---|---|
| 1 | MT3608 OUT+ (отсюда приходит питание) |
| 2 | ESP32-C3, ножка 5V |
| 3 | кольцо 5V |
| 4 | плюс пищалки |
| 5–7 | запас |

Катод диода 1N4148 паяется прямо на ножку пищалки.

**3,3 В: 4 занято + 3 запасных = 7 штырей**

| № | Что |
|---|---|
| 1 | ESP32-C3, ножка 3.3 (отсюда приходит питание) |
| 2 | дисплей VCC |
| 3 | вход PCF8574 №1, VCC (дальше по цепочке №2 и часы) |
| 4 | SW-420 VCC |
| 5–7 | запас |

Всего 44 штыря: две гребёнки PLS-40. Шины 5 В и 3,3 В держать подальше друг от друга или подписать маркером: перепутанный провод с 5 В на 3,3 В сожжёт дисплей и расширители.
