mrTelnor/wizards-staff/JOURNAL.md

# Посох мага: журнал

Формат записи: дата, что делали, что получилось, что не получилось и почему, что делать дальше.

## 2026-09-03

- Написано и утверждено ТЗ ([SPEC.md](SPEC.md)), составлен план работ ([docs/ПЛАН.md](docs/ПЛАН.md) (служебный, в git не входит)).
- Ключевые решения: мозг ESP32-C3 SuperMini в Arduino IDE; кристалл полый, экран в картридже; кнопки через два PCF8574; датчик удара SW-420; аккумулятор 18650 с BMS, зарядка TP4056 с Type-C, повышающий преобразователь MT3608 до 5 В (уточнено при выборе компонентов: один «модуль с зарядкой и 5 В» не берём, это платы повербанков с автоотключением на малой нагрузке).
- Дальше: закупка компонентов по [hardware/bom.md](hardware/bom.md) (задача 1 плана), параллельно настройка Arduino IDE (задача 2).

## 2026-09-04 … 2026-09-07

- Выбраны и заказаны все компоненты, ссылки в [hardware/bom.md](hardware/bom.md). По ходу выбора уточнены решения:
  - питание: TP4056 с Type-C плюс отдельный MT3608 на 5 В вместо «модуля повербанка» (те отключаются на малой нагрузке);
  - аккумулятор: сборка 4000 мА·ч из двух банок, 66×37×19 мм, поэтому рукоять стала корпусом 50–55 мм, заменяющим отрезок трубы;
  - звук: электромагнитный зуммер 12085 через транзистор S8050D, а не пьезо;
  - выключатель по характеристикам тумблер 6 А с отверстием 6 мм, по фото уточнить при получении.

## 2026-09-08

- Получена первая часть посылок: DS3231, три макетные платы на 400 точек, Dupont 120 шт, кабели JST XH2.54, MT3608, резисторы 100 кОм, SW-420, конденсаторы 1000 мкФ, провод ПВАМ 0,75.
- Ждём: ESP32-C3, дисплей, PCF8574 ×2, кольцо, зуммер, транзисторы, TP4056, аккумулятор, тумблер, кнопки, резисторы 470 Ом, провод МГШВ.
- Можно делать без железа: задача 2 плана (Arduino IDE, пакет плат ESP32, библиотеки). Как только приедет ESP32-C3: мигание, затем задача 3 (дисплей).
- С уже приехавшим можно заранее: вставить батарейку в DS3231 (проверить, есть ли она в комплекте). Настройку MT3608 на 5,0 В отложить до прихода аккумулятора и TP4056.

## 2026-09-09

- Получено: провод МГШВ 0,35 мм² (7 цветов), резисторы 470 Ом.
- Ждём: ESP32-C3, дисплей, PCF8574 ×2, кольцо, зуммер, транзисторы, TP4056, аккумулятор, тумблер, кнопки.

## 2026-09-11

- Решение по кристаллу: хрустальный шар 120 мм, заказан силиконовый молд. Шар полый (стенка 8–12 мм, сердечник из пенопласта 100 мм), отверстие молда расширить до 50 мм под картридж. Подробности в ТЗ, раздел 4.2. Гранёный кристалл остаётся запасным вариантом.
- Получено: кольцо WS2812B, транзисторы S8050D.
- Ждём: ESP32-C3, дисплей, PCF8574 ×2, зуммер, TP4056, аккумулятор, тумблер, кнопки.

## 2026-09-14

- Получен аккумулятор 4000 мА·ч с BMS и XH2.54.
- Ждём: ESP32-C3, дисплей, PCF8574 ×2, зуммер, TP4056, тумблер, кнопки.

## 2026-09-16

- Получена плата ESP32-C3 SuperMini (точная дата получения не записана). Модуль зарядки TP4056 получен ещё 2026-09-11, в журнале тогда не отмечен. Ждём: дисплей, PCF8574 ×2, зуммер, тумблер, кнопки.
- Проект переехал из папки «Посох мага» в отдельный репозиторий `wizards-staff`. Имена папок и файлов латиницей: ТЗ → `SPEC.md`, закупки → `hardware/bom.md`, скетч → `firmware/wizards_staff/`. Рабочий план и лог общения остались в служебной папке `docs/`, она в git не входит. Лицензии: MIT на код, CC BY-SA 4.0 на документацию и модели.
- Arduino IDE ещё не установлена. Дальше: задача 2 плана (IDE, пакет плат ESP32, библиотеки, мигание), затем задача 3 (дисплей), как только он приедет.
- Задача 2 закрыта. Arduino IDE 2.3.10 (winget), пакет esp32 3.3.11, библиотеки: Adafruit GFX 1.12.6, ST7735/ST7789 1.11.0, NeoPixel 1.15.5, PCF8574 1.1.2, RTClib 2.1.4. Мигалка залита, синий светодиод на GPIO8 мигает, в Serial Monitor строки «LED on / off».
- Две грабли по дороге:
  - IDE при первом запуске зависала на заставке: на машине корпоративный Kaspersky, `arduino-cli` не мог скачать индексы пакетов. Заработало после того, как индексы всё же скачались; при повторе смотреть отчёты Kaspersky и доступ к `downloads.arduino.cc`.
  - Плата с заводской прошивкой уходила в цикл сброса: Windows каждые несколько секунд «подключала новое устройство» со звуком, COM-порт то появлялся, то пропадал. Лечение: войти в загрузчик (зажать BOOT, воткнуть USB, отпустить), в нём порт стабилен, залить свою прошивку, нажать RST. После этого переподключения прекратились.
- Плата подключена в порт USB 3.0 материнской платы напрямую, определяется как COM3.

## 2026-09-17

- Питание от аккумулятора работает (задача 10, железная часть): TP4056 → тумблер (временно кулисный on-on, средняя и крайняя ножки) → MT3608 → ножки 5V и G платы, делитель 100 кОм + 100 кОм с B+ на ножку 3. Плата стартует от аккумулятора. Цифры замеров (выставленное на MT3608, на 5V платы под нагрузкой, Serial против мультиметра) дописать.
- Грабля: после первого подключения на OUT TP4056 стало 1,7 В при 3,9 В на аккумуляторе. Это защита модуля в отсечке, сбрасывается зарядкой в Type-C или переподключением аккумулятора. После переподключения всё заработало; следить, не срывает ли защиту включение тумблера с MT3608 (бросок тока входного конденсатора). Если будет повторяться: тумблер перенести на сторону 5 В.
- Правило: при подключённом USB тумблер выключен, у SuperMini ножка 5V соединена с USB напрямую. Делитель сидит на B+ до тумблера, поэтому замер заряда работает и при питании от USB.
- Добавлен инструмент `firmware/tools/battery_log/`: пишет напряжение аккумулятора раз в 30 с в файл во флеш платы (LittleFS), команды dump/stat/now/clear через Serial. Для замера автономности без компьютера.
- Логгер заряда запущен и проверен: LittleFS 1408 КБ, файл пишется, `now` показал 3958 мВ, 73 %. Оказалось, он работал с первой заливки (включение №15, 65 строк в логе), просто вывод в Serial не был виден.
- Грабля: пункт Tools → USB CDC On Boot слетает в Disabled при перевыборе платы или порта в IDE, и `Serial` уходит на ножки UART вместо USB. Симптом: скетч работает (диод мигает), Serial Monitor пуст. Проверять этот пункт, если монитор молчит.
- Грабля: после сброса платы Serial Monitor в IDE не переподключается и молча показывает старый текст, а при заливке может держать порт («Could not open COM3, the port is busy»). Лечение: закрыть и снова открыть монитор; при занятом порте закрыть монитор или переткнуть USB.
- Грабля: Arduino IDE перезаписывает открытый в нём файл своей копией, правки в файле с диска не приживаются. Перед правкой скетча снаружи закрывать его вкладку в IDE или переоткрывать файл после правки.
- Первый замер автономности логгером: с 73 % (3958 мВ) до 68 % за ~9 часов ночью. Это около 200 мА·ч, потребление платы с MT3608 без сна примерно 20–25 мА. Экрана, кольца и кнопок пока нет, так что это нижняя граница расхода.
- Начат этап 2, связь с телефоном: план в `docs/ПЛАН-APP.md`. Основное устройство планшет HUAWEI MatePad SE 11 (HarmonyOS 2.0, Android 10, API 29, экран 1200×1920). Установлена Android Studio 2026.1.4, планшет виден через `adb` (после подтверждения отладки на экране планшета, до этого статус `unauthorized`). Создан пустой проект `app/`: Kotlin, Compose, minSdk 29, targetSdk 37, AGP 9.4, Gradle 9.6. «Hello Android!» запустился на планшете. Задача A1 закрыта.
- Задача B1 этапа 2 закрыта: посох виден по Bluetooth как `WizardsStaff`, отдаёт заряд в Battery Service и в JSON раз в 10 с, отвечает на `info` и `time`. Проверено с планшета через BLE Scanner (Bluepixel). Библиотеки NimBLE-Arduino 2.5.1 и ArduinoJson 7.4.3, Partition Scheme «Minimal SPIFFS», прошивка 611 КБ.
- Грабли BLE: рекламный пакет всего 31 байт, длинный UUID сервиса плюс имя в него не влезают, и реклама в NimBLE 2.x молча не стартует. Имя теперь в рекламном пакете, UUID в ответе на сканирование. Часть сканеров не показывает имя из ответа на сканирование (показывали N/A), поэтому имя должно быть именно в рекламе. Команду от телефона считаем законченной по закрывающей скобке JSON: BLE Scanner не умеет отправлять перевод строки.
- Грабля IDE: Arduino IDE трижды перезаписывала `ble.h` содержимым другой вкладки. Перед заливкой проверять первую строку каждой вкладки; после правок с диска перезапускать IDE без сохранения.
- Датчик SW-420 подключён к макетке (VCC → 3.3, DO → ножка 20). У этого модуля выход в покое активен и гаснет при ударе, прошивка ловит любое изменение уровня, поэтому направление не важно. Чувствительность винтом на макетке получается высокой: провода Dupont передают дрожание. Пауза после броска 5 с (`STRIKE_COOLDOWN_MS`), в посохе удар считается только у взведённого посоха; запасной ход — программный фильтр силы удара, записан в план этапа 2 как шаг 3а задачи B3.
- Датчик удара работает с фильтром силы: считаем переключения выхода SW-420 в окне 100 мс, удар от 10 переключений (`STRIKE_MIN_EDGES`, подобрано по Serial: перемещение макетки даёт единицы, удар по столу пачку). Пауза после броска 5 с. Удар бросает d20 и отдаёт событие `roll` на планшет; команда `roll` с планшета бросает без стука. Задача B3 этапа 2 закрыта в части датчика (шаги 1 и 3а), часы DS3231 остаются.
- Часы DS3231 (модуль ZS-042 с памятью AT24C32) подключены к I2C: GND, VCC → 3.3 В, SDA → ножка 0, SCL → ножка 1. Питание именно 3,3 В: подтягивающие резисторы шины на модуле сидят на VCC, от 5 В они тянули бы ножки платы выше допустимого. Свой драйвер `rtc.h` на `Wire` вместо библиотеки: у часов семь регистров времени в двоично-десятичном виде. Время внутри и в протоколе по UTC, местное считается смещением `TZ_OFFSET_MINUTES` (180, Москва) и нужно только для печати. Часы, потерявшие питание, получают время сборки прошивки, точное приходит с планшета. Время и заряд печатаются одной строкой раз в 10 с.
- Про батарейку модуля: цепь подзарядки на плате рассчитана на аккумулятор LIR2032. При нашем питании 3,3 В она не работает вовсе (после диода остаётся около 2,7 В), поэтому обычная CR2032 в безопасности и выпаивать резистор `201` не нужно. Ставим CR2032: у неё 220 мА·ч против 40 у LIR, при потреблении часов в единицы микроампер это годы.
- Приложение: перенесены токены темы и шрифты из `docs/design`, написаны `ble/StaffBle.kt` (поиск, подключение, уведомления, разбор строк), `ble/Protocol.kt`, `StaffViewModel.kt`, экраны «Броски» и «Посох», диалог про геолокацию. Разбор JSON встроенным `org.json`, без плагина сериализации. Броски пока живут в памяти. Пока нет кнопок на посохе, кость выбирается в приложении: команда `arm` взводит посох, удар об пол бросает выбранное, невзведённый посох удары не считает, взвод спадает через 30 с.
- Грабля Android: система выполняет одну операцию GATT за раз. Две записи подряд без ожидания ответа — вторая молча пропадает. В клиенте очередь на запись, следующая идёт по колбэку `onCharacteristicWrite`.
- Проверено на планшете: поиск, запрос геолокации, подключение, заряд в рейке, взвод, бросок от удара по столу, приход броска в ленту.

## 2026-09-18

- Грабля BLE в прошивке: буфер принятых команд был на одну штуку, и пока главный цикл не разберёт первую команду, символы следующей выбрасывались. Приложение при подключении шлёт `info` и `time` подряд, вторая терялась целиком — часы посоха не подводились, а выглядело это как «приложение не синхронизирует время». Сделана очередь на шесть команд. В ответ `info` добавлено поле `ts` со временем посоха, приложение показывает расхождение с планшетом и умеет синхронизировать кнопкой.
- Посох шлёт диагностику по Bluetooth событием `{"ev":"log","msg":"…"}`: итог каждой пачки переключений датчика, удар при невзведённом посохе, удар в паузе после броска, спавший взвод. То же самое, что печаталось только в монитор порта.
- В приложении появился экран «Логи посоха» (кнопка в разделе «Посох»): строки обмена в обе стороны с временем, поиск по тексту, переключатель автопрокрутки, отправка команды руками с быстрыми кнопками, сохранение в файл `wizards-staff-logs-ГГГГ-ММ-ДД-ЧЧ-ММ-СС.txt` через системный выбор места (без разрешений на память). Там же в разделе «Посох» краткий справочник команд с примерами ответов.
- Грабля: счётчик номеров броска в прошивке живёт в оперативной памяти и обнуляется при выключении питания. После перезапуска посоха приложение считало броски №1, №2 повторами старых и не показывало их в ленте, хотя в журнале они были. Теперь бросок опознаётся парой «сеанс связи + номер». Окончательно решится в задаче B2, когда номер переедет во флеш посоха.
- Разметка «Бросков» подстраивается под ширину экрана: две колонки как в макете от 900 dp, уже — один столбец. Макеты рисовались для альбомной ориентации, в портретной лента сжималась до нечитаемой ширины.
- Тёмная тема: свежий бросок в ленте выделялся заливкой из макета (светлый `#F5F9FE`), в тёмной теме получалось белое на белом. Выделяем рамкой цвета акцента, заливка только у критов.
- Добавлена анимация броска: числа прокручиваются барабаном около секунды и останавливаются на выпавшем, слагаемые до остановки скрыты. Длительность в `ROLL_SPIN_MS`, её потом надо согласовать с анимацией на экране посоха (`ROLL_ANIM_MS`, 1500 мс).
- Прошивка 0.3.1, 645 КБ (32 %). Дальше: задача B2 (история бросков во флеш, номера сквозные, кости кнопок в Preferences), потом база Room в приложении и подписи к броскам.
- Большой разбор планов этапа 2. Отменена задача B4 (жесты ударом): много возни ради малого, дождёмся кнопок. Задача D4 (преимущество и помеха) отложена к приезду кнопок и дисплея: как удобнее переключать режим — вопрос живого управления. Для базы в приложении выбран Room, а не `SQLiteOpenHelper`: SQL проверяется при сборке, `Flow` даёт самообновление ленты, таблиц будет четыре. Перед началом C2 нужна проверка совместимости KSP с AGP 9.4.
- Порядок работ пересмотрен: задача B2 обязана идти до C2. Счётчик сеансов связи, которым приложение сейчас обходит сброс номеров, работает только пока лента живёт в памяти; с базой Room ключ «сеанс + номер» после перезапуска приложения повторится и новые броски будут отброшены как дубликаты.
- Решено, как защищать посох: PIN из четырёх цифр, без PIN нет связи (10 секунд на команду `auth`, иначе посох сам разрывает соединение), одновременное подключение только одно. Нарастающая блокировка при подборе: 3 промаха — минута, 6 — пять минут, 9 — десять, 12 и далее каждые 3 — час. PIN хранится в NVS, при первой заливке берётся из gitignored `secrets.h`, меняется из приложения. Белого списка устройств не делаем: Android подставляет случайный адрес и меняет его примерно раз в 15 минут, постоянный виден только после настоящего сопряжения BLE, от которого мы отказались.
- Обновление прошивки по Bluetooth вынесено в отдельный этап F, делается после сборки посоха. Причина: наружу рукояти выведен только Type-C зарядки от TP4056, свой USB платы остаётся внутри, и после закрытия рукояти на четыре винта обновление по воздуху становится единственным способом что-то поправить. Манифест релиза решено не делать: версию и ссылку GitHub отдаёт сам через API, а sha256 обязан считать планшет по тем байтам, что скачал, — хеш из манифеста защищал бы участок, уже закрытый HTTPS.
- Синхронизация с сервером telnor.ru вынесена за релиз. Проработка лежит в `home-page/docs/wizards_staff_sync.md`. До релиза данные живут только в Room на планшете.

### Задача B2, шаги 0–4

- Замерен раздел под файлы: **LittleFS 128 КБ, свободно 120 КБ**. Надпись «190KB SPIFFS» в меню Arduino IDE оказалась неточной, права стандартная таблица arduino-esp32. Раздел после смены схемы разделов был не отформатирован, отформатирован скетчем.
- Добавлен `identity.h`: `staffId`, случайное 32-битное число, придумывается при первом старте и живёт в NVS. Нужен помимо MAC потому, что счётчик номеров бросков лежит в той же NVS: если она потрётся, номер посоха сменится вместе со сброшенным счётчиком, и приложение поймёт, что нумерация началась заново, а не свалит старые и новые броски в кучу. Генерация вызывается после `bleBegin()`: генератор случайных чисел у ESP32 полноценен только при включённом радио. В ответ `info` добавлены `staffId` и `mac`.
- Добавлен `history.h`: кольцевой файл `/rolls.bin`, шапка с подписью и версией формата, 1500 записей по 36 байт (54 КБ, 45 % раздела). Больше половины оставлено свободным: LittleFS пишет копированием блоков и на забитой файловой системе работает плохо. Позиция следующей записи не хранится, а вычисляется при старте поиском наибольшего номера. Выдача истории обходит кольцо начиная со свободной ячейки, поэтому записи выходят по возрастанию номера без сортировки.
- Номер броска хранится в двух местах сразу — в NVS и в самом файле, при старте берётся больший. Это переживает потерю любого одного хранилища: NVS стирается при смене схемы разделов, файл — при форматировании LittleFS, и оба события у нас уже случались по отдельности.
- Найдена и исправлена ошибка, которая уже была в коде: в структуре `Roll` поля `sides` и `values` были однобайтовыми, а `.ino` пропускал `d` до 1000. Запрос d1000 молча превращался в d232 (остаток от деления на 256). Грани и значения стали двухбайтовыми, `DICE_SIDES` тоже.
- `HISTORY_SIZE` (5, история для экрана самого посоха по ТЗ) разведён с `HISTORY_FLASH_SIZE` (1500). В ответе `info` поле `hist` теперь отдаёт ёмкость флеш-истории, раньше туда ошибочно уходила экранная.
- Проверено на плате: номер посоха переживает сброс, номера бросков сквозные и после перезапуска продолжаются, а не начинаются с единицы. Самопроверка генератора прогнана три раза подряд, на каждой грани 950–1053 при ожидаемых 1000 — критерий задачи 13 выполнен.
- Прошивка 0.4.0. Дальше в B2: команда `hist` для выдачи истории на планшет, таблица костей в Preferences.

## 2026-09-19

### Задача B2, шаги 5–6

- Таблица костей переехала из константы в Preferences (`diceLoad`, `diceSave`), команда `map` её меняет. Пишется только целиком: если хоть одно из восьми значений вне 2…1000, отказ. Половина новой таблицы и половина старой хуже, чем внятная ошибка.
- Команда `hist` отдаёт историю **порциями по 50** и заканчивает новым событием `histend` с полями `sent`, `last`, `more`. Порции понадобились из-за скорости BLE: `bleSend` режет строку по размеру пакета и ждёт 5 мс после каждого куска, поэтому одно событие `roll` занимает от 5 до 25 мс, а 1500 записей подряд заморозили бы главный цикл почти на минуту — посох всё это время не опрашивал бы датчик удара.
- Свежий бросок и запись из истории уходят одинаковым событием `roll` через общую `sendRollEvent()`: приложение не должно их различать, дедупликация по паре `(staffId, id)` одна на оба случая.

### Единый журнал служебных сообщений

- Все 38 служебных сообщений прошивки приведены к одному виду: `ГГГГ-ММ-ДД ЧЧ:ММ:СС.ммм МОДУЛЬ уровень: текст`. Имена модулей латиницей (`BOOT`, `TIME`, `FS`, `HISTORY`, `ID`, `BLE`, `DICE`, `STRIKE`, `CHARGE`, `ROLL`, `BATTERY`), тексты по-русски. Уровень прижат вправо, поэтому `ERROR!` торчит из столбца и заметен при беглом просмотре. Уровни: `info`, `warn`, `ERROR!`.
- Всё это живёт в новом `log.h`, одной функцией `logLine()`. Приёмник для приложения ставится указателем на функцию из главного скетча, чтобы `log.h` и `ble.h` не включали друг друга по кругу.
- `rtcBegin()` перенесён в начало `setup()`: иначе первые шесть строк журнала оставались бы без времени. Если часов нет, печатается время от включения со знаком плюс той же ширины.
- Миллисекунды считаются от пары «часы плюс `millis()`», а не чтением DS3231 на каждой строке: чтение по I2C занимает около миллисекунды. Грабля по дороге: сначала пара обновлялась перед каждой печатью строки заряда, отсчёт обнулялся, и у всех этих строк стояло `.000`. Теперь подтяжка только при расхождении больше двух секунд.
- `logLocal()` — для того, у чего в приложении есть свой канал: заряд приходит событием `bat`, а строка `BLE: команда X` и так стоит под отправленной командой. Гонять один факт дважды по узкому каналу BLE ни к чему.
- Буфер на 30 строк (около 3 КБ): пока планшета нет, журнал копится и выливается при подключении. Грабля: сливать по таймеру через 500 мс бесполезно — Android сначала подключается, потом ищет службы, потом подписывается на уведомления, и всё это больше секунды. Слить раньше подписки значит отправить в пустоту. Теперь слив идёт по первой команде от планшета (она приходит уже после подписки), запасной таймер 3 с — на случай подключения сторонней программой, которая молчит.
- Из `strike.h` убраны `strikeLastEdges` и `strikeWindowClosed`: они существовали только чтобы главный скетч пересказал результат телефону, теперь датчик пишет в журнал сам.

### Приложение

- Экран логов: фильтр «Всё / Инфо / Ошибки», по умолчанию «Инфо». Решено фильтровать в приложении, а не заводить уровень в прошивке: ничего не теряется, переключиться можно задним числом, и прошивку трогать не надо. Уровень определяется по самой строке — это последнее слово перед первым двоеточием **с пробелом**; во времени двоеточия есть, но пробела после них нет, спутать нельзя.
- На экране «Посох» появилась карточка с расшифровкой всех одиннадцати модулей журнала. Справочник команд пополнен `hist` и `map` и поправлен: там оставались зашитые «fw 0.3.0» и «история 5 записей», оба молча устарели.
- Отсюда правило: **если приложение показывает число из прошивки, оно спрашивает его у посоха, а не хранит копию.** Так теперь работает время жизни взвода: посох отдаёт его в `info` полем `arm`.
- Быстрые команды под строкой ввода приведены к одному виду (русские глаголы вместо смеси `info` и «отбой»), добавлена «история».

### Прочее

- **Взвод живёт 5 минут вместо 30 секунд** (решение автора, ТЗ раздел 2.3 с пометкой об изменении). На игре ход возвращается к игроку через несколько минут, а взводить принято заранее. Риск небольшой: удар засчитывается только по пачке от десяти переключений датчика за 100 мс.
- Найдена и исправлена ошибка, которая уже была в коде: структура `Roll` держала `sides` и `values` в одном байте, а `.ino` пропускал `d` до 1000, так что запрос d1000 молча превращался в d232 (остаток от деления на 256).
- **«Кубик» переименован в «кость»** во всех документах и во всём коде: кубик там только d6. Замена не механическая, род поменялся с мужского на женский, и в девяти местах пришлось руками править согласование («какой кубик взведён» → «какая кость взведена»). Транскрипт разговоров с агентом не трогали.
- Замер: раздел LittleFS 128 КБ, свободно 120 КБ. Надпись «190KB SPIFFS» в меню Arduino IDE неточна.
- Дальше: закрыть проверку B2 (`map` с перезапуском, бросок d1000), затем задача B5 (PIN и защита подключения), затем C2 (база Room).

### Задача B2 закрыта

- Проверка шага 7 прошла на плате: таблица костей переживает перезапуск, бросок d1000 честный, граница порции `hist` и пустая порция отрабатывают как задумано. Задача B2 закрыта.
- Запись выше про d1000 оказалась неполной. Двухбайтовые поля в `Roll` вылечили хранение, но обрезание случалось раньше — на разборе команды, и до сегодняшнего дня d1000 всё так же не работал.
- **Грабля.** В строке `int d = cmd["d"] | DEFAULT_SIDES;` оператор `|` у ArduinoJson смотрит на тип значения справа, а `DEFAULT_SIDES` был `uint8_t`. Если присланное число в этот тип не влезает, библиотека молча отдаёт значение по умолчанию. Поэтому d100 работал, d999 и d1000 превращались в d20, а d1001 не получал отказа `bad roll`: до проверки границ `d` уже равнялся двадцати. Лечение: константа стала `uint16_t`, в обоих местах разбора (`arm` и `roll`) добавлено явное `(int)`.
- Рядом нашлась вторая мина того же рода: `armedSides` был `uint8_t`, то есть взвод на 1d1000 записал бы 232 и удар об стол бросил бы d232. До проверки дело не дошло только потому, что разбор команды ломался раньше. После правки проверено: взвод 10d1000, удар об стол, бросок №58 = 4574 со слагаемыми 596+547+681+12+102+340+391+180+812+913.

### Журнал служебных сообщений: убран буфер старта

- Решение автора: историю загрузки на планшет не гнать. На этапе разработки плата и так подключена к ПК, для глубокого разбора есть монитор порта. Убраны буфер на 30 строк (около 3 КБ оперативной памяти), `logFlush()`, четыре флага слива в `loop()` и константа `LOG_FLUSH_FALLBACK_MS`. Живой журнал при подключённом планшете не изменился.
- Вместе с кодом отпала и вчерашняя морока со сливом раньше подписки Android: сливать больше нечего.

### Отказы стали видны человеку

- Раньше `bleSendError` отдавала только машинное событие `{"ev":"err","msg":"…"}`. Под фильтром «Инфо» машинный JSON скрыт, и отказ выглядел как молчание посоха: команда ушла, ответа нет.
- Теперь рядом с кодом уходит строка журнала по-русски и с подробностями: сколько костей пришло в `map`, какая из них плоха, что за команда незнакома. Уровень `warn`, а не `info`, чтобы отказ попадал ещё и в фильтр «Ошибки».
- Код ошибки на проводе остался английским: он часть протокола, по нему приложение когда-нибудь будет разбирать причину само.

### Грабля: буферы под русский текст меряются в байтах

- Первая версия человеческих отказов обрывалась на полуслове, а в одном месте вместо буквы приложение показывало ромбик с вопросом.
- Причина: буферы отмерены как под латиницу, а русская буква в UTF-8 занимает два байта. Замер: фраза «в команде map должно быть ровно 8 костей, пришло 7» — 50 символов, но **85 байт** при буфере 80. Самое длинное из сообщений об отказе занимает 101 байт.
- `snprintf` режет строку по размеру буфера, не глядя на границы символов, и рассекает букву пополам. Половина буквы — недопустимый UTF-8, приложение рисует на её месте ромбик.
- Лечение в двух слоях: все пять буферов сведены к одной константе `BLE_ERROR_TEXT = 160`, и в `log.h` добавлена `logTrimBrokenUtf8()` — перед печатью оборванный хвост символа отбрасывается целиком. Второй слой страхует любые длинные русские строки во всех модулях, а не только отказы.

### Сборку можно проверять без IDE

- Скетч собирается `arduino-cli` из поставки Arduino IDE: `%LOCALAPPDATA%/Programs/arduino-ide/resources/app/lib/backend/resources/arduino-cli.exe`, команда `compile --fqbn esp32:esp32:esp32c3:CDCOnBoot=cdc,PartitionScheme=min_spiffs`. Удобно ловить ошибки компиляции, не открывая IDE и не занимая COM-порт.
- Прошивка 0.4.2: 722 567 байт (36 %), глобальные переменные 25 104 байта (7 %).

### Записано задним числом: ночь на 19 сентября

- **Клавиатура перестала закрывать поле ввода команд.** `windowSoftInputMode="adjustResize"` в манифесте перестал действовать ровно в тот момент, когда включили `enableEdgeToEdge()`: она отдаёт приложению всю площадь экрана вместе с системными полосами, и автоматическая подгонка окна под клавиатуру уходит вместе с ней. Про клавиатуру приложение должно узнавать само.
- **Иконка приложения, пиксельный посох.** Значки всех плотностей собраны из `app/icon/icon-512.png` методом ближайшего соседа: обычное сглаживание замылило бы пиксель-арт. Передний слой адаптивной иконки занимает центральные 72 dp из 108 — зону, которую маска лаунчера не обрезает ни при какой форме. Монохромного слоя нет намеренно: цветной пиксель-арт в силуэте превращается в сплошное пятно. Исходник и генератор лежат в `app/icon/`, чтобы иконку мог перерисовать не только автор.

### Интерфейс приложения: прокрутка и клавиатура

- **Раздел терялся при повороте.** Текущий раздел и флаг «открыты логи» хранились в `remember`, а поворот планшета пересоздаёт активность, и `remember` начинается заново: из логов приложение возвращалось в «Броски». Заменено на `rememberSaveable`. Тем же лечением закрыты два флага диалогов — диалог разрешений при повороте просто исчезал. Связь с посохом поворот не рвал и раньше: она живёт во `ViewModel`, а та пересоздание переживает.
- **Окно поджималось под клавиатуру.** `imePadding()` на каркасе приложения подгонял высоту окна: журнал схлопывался, а строка ввода с быстрыми командами уезжала за край экрана. Убран. Теперь клавиатура ложится поверх, и размеры разметки не меняются ни в альбомной ориентации, ни в портретной.
- **Экран логов поднимает содержимое сам.** Внешний столбец прокручивается, внутренний всегда ровно в высоту экрана — отсюда и постоянство размеров, журнал делит остаток по `weight`. Под ними распорка ровно в высоту клавиатуры: она и даёт, куда мотать. Курсор встал в строку команды, выехала клавиатура — экран мотается в самый низ, и строка ввода с быстрыми командами оказывается точно над ней. Убрали клавиатуру — вернулся на место.
- Подъём работает только ради строки команды. Поиск живёт наверху, клавиатура его не закрывает, и если мотать вниз и ради него, поиск уедет за верхний край.
- **`windowSoftInputMode="adjustResize"` в манифесте остаётся, хотя окно больше не подгоняется.** На Android 10, а это и есть планшет MatePad, система сообщает приложению высоту клавиатуры только в этом режиме, а без неё поднимать содержимое не на что. Само сжатие разметки выключено тем, что `enableEdgeToEdge()` отдаёт приложению всю площадь экрана. Пояснение написано прямо в манифесте, чтобы атрибут потом не «почистили» как лишний.
- **Левая колонка «Бросков» прокручивается.** В альбомной ориентации карточки «последний бросок» и «взвод» с сеткой из восьми костей по высоте не помещались: нижний ряд `d10 d12 d20 d100` уходил за край экрана, и нажать его было нельзя.

### Решения и цифры, дозаписанные 19 сентября

- **Питание, замер:** на MT3608 выставлено **5,05 В** без нагрузки, под нагрузкой при 60 % заряда аккумулятора — **5,01 В**. Цифры ждали записи с сентября, теперь закрыты.
- **Сторонний BLE-терминал** для отладки без своего приложения: использовался **BLE Scanner (Bluepixel)**, а не nRF Connect — на MatePad нет Play Market. Сейчас нужда в нём отпала совсем: у приложения есть свой экран логов с отправкой команд руками.
- **Проверка приложения на телефонах отложена** (Pixel 8 и POCO X7 Pro) до готовности листа персонажа. Основная разработка — посох и планшет, телефоны вторичны.
- **Замер MAC-адреса планшета отменён.** На разработку не влияет: белого списка устройств мы не делаем, и вывод от замера не изменится.
- **Терминология для задачи D4:** «преимущество» и «помеха», термины D&D. Система популярнее, хотя автор сейчас играет по PF2e.
- **Установка прошивки и приложения делается из IDE** — Arduino IDE и Android Studio, — а не из командной строки. Сборку агент проверяет своими средствами, но заливает на железо всегда человек и всегда из IDE.
- **ТЗ, раздел 7а переписан.** Назывался «Идеи на потом (этап 2, после запуска посоха)» и описывал этап 2 как незапланированный, хотя тот идёт с 17 сентября и наполовину сделан. Цифры в старой редакции устарели: обещалась «история с 5 до 50 бросков в Preferences», а на деле 1500 записей в LittleFS. Теперь раздел называется «Этап 2: связь с планшетом и приложение» и делится на решения, сделанное и оставшееся.
- **Таблица файлов в `firmware/README.md` приведена к правде:** добавлены `log.h`, `history.h`, `identity.h`, `ble.h`, а ещё не написанные `buttons.h`, `display.h`, `lights.h`, `sound.h`, `settings.h` вынесены в отдельную таблицу «появятся по мере сборки». Туда же дописано, что «190KB SPIFFS» в меню IDE — неточная надпись, на деле 128 КБ.

### Проверка KSP и Room перед задачей C2

- KSP **2.2.10-2.0.2** (номер версии у KSP всегда склеен из версии Kotlin и своей, Kotlin у нас 2.2.10) и Room **2.8.5** с AGP 9.4 работают. Но не сразу.
- **Грабля.** Первая сборка упала: `Using kotlin.sourceSets DSL to add Kotlin sources is not allowed with built-in Kotlin`. KSP кладёт сгенерированный код в `kotlin.sourceSets`, а встроенный в AGP 9 компилятор Kotlin это запрещает: отдельного Kotlin Gradle Plugin в сборке нет, Kotlin компилирует сам AGP. Лечится одной строкой `android.disallowKotlinSourceSets=false` в `gradle.properties`, её подсказывает сам AGP в тексте ошибки. Без неё связка не собирается вовсе.
- Проверялось не по принципу «сборка прошла, и ладно». Задача `:app:kspDebugKotlin` отработала, Room сгенерировал реализации `@Dao` и `@Database`. После этого в `@Query` намеренно подставлено несуществующее имя столбца — сборка упала с `no such column: nomer`. Значит, разбор SQL при компиляции действительно работает, и решение от 18 сентября в пользу Room подтверждено делом, а не описанием из документации.
- Проверочные классы удалены. Обвязка сборки оставлена подключённой: она же и есть первый шаг задачи C2.
- Room 3.0 вышел в марте 2026, ветка 2.x переведена в режим поддержки — новых возможностей не будет, только исправления. Берём 2.8.5: схема у нас простая, четыре таблицы, а переезд на 3.x лучше делать, когда тот устоится.
- **Решение автора: схему Room выгружаем в JSON.** Подключается плагин `androidx.room` с `schemaDirectory`, файлы схемы кладутся в git. Это нужно для миграций, когда таблицы начнут меняться: база с бросками за год игр — не то, что хочется потерять на кривой миграции. Вариант `exportSchema = false` отклонён. Применим вместе с первой таблицей: пока в проекте нет ни одного `@Database`, выгружать попросту нечего.

### Задача B5: PIN и защита подключения

- Прошивка **0.5.0**. Без PIN посох не отвечает ни на что, кроме сокращённых сведений о себе: `fw`, `staffId`, `mac`, `pinset`. Всё остальное закрыто, **включая `roll`, `arm` и `disarm`** — настоящая пакость за игровым столом это подкинутый бросок или снятый в нужный момент взвод, а не смена настроек подсветки. Не назвался за 10 секунд — посох разрывает связь сам.
- PIN живёт во флеш и берётся из `secrets.h` только при первом запуске. Дальше файл не читается: иначе вышла бы ловушка «поменял в файле, залил, а PIN старый». Сменить можно только командой `pin`, и она требует старый PIN даже у того, кто уже вошёл: планшет могли оставить на столе разблокированным.
- `secrets.h` закрыт в `.gitignore` **до** того, как был создан. Попавший в коммит секрет остаётся в истории навсегда, даже если удалить его следующим коммитом. Рядом лежит `secrets.example.h`. Подключается через `__has_include`: если файла нет, скетч всё равно собирается и посох работает без защиты — это лучше, чем непонятная ошибка компиляции у того, кто повторяет проект по описанию.
- Лестница пауз при подборе целиком внутри `authTry()`: 3 промаха — минута, 6 — пять минут, 9 — десять, дальше час на каждом третьем. Счётчик в оперативной памяти, выключение его стирает. Это сознательно: тумблер на рукояти, кто дотянулся до него, дотянется и до винтов, зато флеш не изнашивается неудачными попытками.
- Сравнение времени блокировки написано вычитанием, а не «меньше»: `millis()` переполняется через 49 суток, и прямое сравнение в этот момент дало бы вечную блокировку. Посох столько не проработает, но такие вещи дешевле написать правильно сразу.
- Одновременное подключение одно: на время связи реклама гаснет, посоха в эфире не видно, и второй не может даже попробовать PIN.
- Новый, двенадцатый модуль журнала — `AUTH`.

### Приложение: вход по PIN

- Задачи в плане не было: B5 значилась как работа только для прошивки. Но залитая защита кладёт планшет целиком — приложение подключается, получает отказ на `time` и через десять секунд теряет связь, и так по кругу. Это было видно в журнале сразу после первой заливки. Задача заведена как **C5** и поставлена следом за B5.
- Вся развилка входа в одном месте, в `afterInfo()`: посох без защиты — идём работать; вход уже открыт — ничего не делаем; PIN нужен и планшет его знает — называет молча; не знает — спрашивает человека.
- PIN хранится по адресу BLE в обычных `SharedPreferences`. Адрес известен ещё до подключения, из результатов поиска, поэтому нужный PIN подставляется сразу. Шифрованное хранилище не берём: от шутника за столом защищает сам PIN, а от того, у кого в руках разблокированный планшет, не спасёт ничего, что мы можем сделать за разумное время.
- **Три места, где легко было ошибиться.** Сокращённые сведения нельзя разбирать как полные: там нет ни костей, ни времени посоха, и расхождение часов вышло бы «минус пятьдесят шесть лет». Отвергнутый PIN приложение забывает — иначе долбило бы им посох каждые десять секунд и само набрало бы промахов на часовую паузу. Набранный руками PIN переживает разрыв связи: пока его вводят, посох успевает закрыться по таймауту, и набранное должно уйти в следующий же сеанс.
- Причина отказа хранится отдельно от состояния входа. Состояние обнуляется при каждом разрыве, а посох рвёт связь каждые десять секунд, и сообщение «неверный PIN, ждать 60 с» пропадало бы почти сразу после того, как его прочитали.
- Смена PIN просит новый дважды. Посох примет опечатку молча, и тогда PIN будет знать только этот планшет; сотрёшь данные приложения — и в посох не войти, пока не перезальёшь прошивку с очисткой памяти.
- **Известная дырка, не закрыта.** Если окно ввода PIN закрыть, вернуть его нечем: кнопка «PIN» живёт в карточке подключённого посоха, а та показывается только после входа. Помогает только переподключение.

### Кости: порядок и запрет повторов

- Команда `map` принимала что угодно: таблица с двумя `d4` сохранялась как есть, и кости шли в том порядке, в каком их прислали. На экране «Броски» это выглядело как `d3 d4 d6 d8 d4 d10 d12 d20`.
- Появилась `diceNormalize()` в `dice.h`: сортирует по возрастанию вставками (значений восемь, городить сложнее незачем) и возвращает грань, встретившуюся дважды. Отсюда внятный отказ `кость d4 задана дважды, все восемь должны быть разными`.
- **То же правило применяется при чтении из флеш.** Иначе негодная таблица, записанная старой прошивкой, осталась бы в памяти посоха навсегда: новая команда её не перезапишет, а старое значение уже лежит. Теперь при старте такая таблица отвергается с записью в журнал и посох возвращается к значениям по умолчанию.
- Следствие, которое стоит помнить к приезду кнопок: сортировка отнимает возможность разложить кости по кнопкам произвольно, например поставить d20 первой под большой палец. Сейчас кнопок нет, и это ничего не стоит, но решение может захотеться пересмотреть.
- Прошивка 0.5.1.

### Приложение: правки по итогам первой проверки входа

- **Кнопка «Ввести PIN».** Окно ввода можно было закрыть, и вернуть его было нечем: метод `showPinPrompt()` я написал, но ни к чему не привязал — мёртвый код. Теперь кнопка на карточке посоха меняет смысл вместе с состоянием: посох закрыт — «Ввести PIN», вход открыт — «PIN» для смены. Заодно ушла вторая нелепость: до входа открывалось окно смены PIN, которое посох всё равно отвергал ответом `auth required`.
- **Экран перестал мигать.** Состояние «нужен PIN» теперь переживает разрыв связи. Раньше оно сбрасывалось при каждом обрыве, то есть каждые десять секунд, и разметка прыгала между карточкой посоха и списком поиска, будто что-то сломалось. Связь под карточкой по-прежнему рвётся и восстанавливается, просто человек этого больше не видит.
- В карточке появились честные подсказки: в «СОСТОЯНИЕ» пишется «закрыт», под часами вместо расхождения — «Посох закрыт: сначала введи PIN», кнопка «Синхронизировать» серая. Раньше она молча отправляла команду, которую посох отвергал.
- **«Логи» больше не обрезаются до «Л».** Причина была не в нехватке места: кнопки стояли в одном ряду с фактами и получали между собой большой отступ фактов, 24 точки. Теперь кнопки живут своим рядом с маленьким зазором, а поля внутри них уменьшены со стандартных 24 до 12.
- **Глазики в полях PIN.** Во всех четырёх: в окне входа и в трёх полях смены. Не косметика: клавиатура закрывает пол-экрана, ошибиться в четырёх точках легко, а посох за три промаха берёт паузу в минуту. Иконка нарисована контуром в том же стиле, что остальные; `material-icons-extended` ради одного глаза не подключали, он тянет тысячи лишних.

### Задача C2: база Room и лента бросков

- Лента переехала из памяти в базу. Room 2.8.5, одна таблица `rolls`, схема выгружается в JSON и лежит в `app/app/schemas` — это слепок таблиц на каждую версию, по нему Room проверяет миграции, а человек видит, что именно поменялось.
- **Ключ записи составной: `(staffId, id)`.** Ради этого и делалась B2 раньше C2. Повторы отсеивает сама база вставкой с `IGNORE`. Именно пропустить, а не перезаписать: у уже лежащей записи может быть подпись или пометка «не засчитан», и догрузка истории не должна их стирать. Счётчик сеансов связи из `StaffViewModel` убран совсем — он был обходом отсутствия сквозных номеров.
- **По дороге вскрылось:** приложение вообще не знало номера посоха. Событие `roll` его не содержит, он приходит только в ответе на `info`. Теперь номер запоминается при подключении и приписывается входящим броскам; если посох почему-то не назвался, бросок **не записывается**, а в журнал уходит заметка. Иначе ключ вышел бы общим для всех посохов и записи затирали бы друг друга.
- Значения костей лежат одной ячейкой строкой вида `2,4,5`. Отдельная таблица ради нескольких чисел означала бы соединение при каждом чтении ленты, а так строку прочтёт и человек, если заглянет в базу отладчиком.
- **Столбец `values` — ключевое слово SQL.** Room взял его в обратные кавычки в сгенерированном `CREATE TABLE` сам; проверено по выгруженной схеме. Своими руками на этом легко было споткнуться.
- Сортировка в SQL идёт по времени посоха, когда оно известно, иначе по времени получения планшетом. По одному `staffTime` броски с невыставленными часами уехали бы в самый низ ленты, в 1970 год. В ленте такое время помечается звёздочкой: после догрузки истории «19:05» без пометки выглядело бы замером, которого никто не делал.
- Лента грузится страницами по сотне: лимит растёт, когда домотали до последней карточки. Библиотеку `androidx.paging` не брали — за вечер игры набегает пара десятков бросков, а она тянет две зависимости и заметно больше кода.
- Подпись к броску — долгим нажатием на карточку. Кнопку на каждой карточке не ставили: подпись нужна не каждому броску, а лишняя иконка засоряла бы ровно то, ради чего на ленту смотрят. Пустая строка стирает подпись.
- Проверено на планшете: бросок и пометка «не засчитан» переживают перезапуск приложения; после перезапуска и посоха, и приложения старые броски не затираются, а новые появляются.

### Задача C4: догрузка пропущенных бросков

- Приложение при подключении просит у посоха всё, что тот накопил без планшета. Спрашивается один раз за сеанс, ровно там же, где подводятся часы: как только открылась дверь по PIN. Раньше нельзя — посох закрыт и откажет, позже незачем.
- **Отсчёт от последнего номера этого посоха**, а не от последнего вообще. Если память посоха когда-нибудь потрётся, он придумает себе новый номер, отсчёт начнётся заново, и приложение честно скачает его историю с начала, не приняв старые записи за уже имеющиеся.
- Дальше идём по подсказкам посоха: пришло `histend` с `more` — просим следующую порцию с номером из `last`. Считать самим ничего не нужно.
- Страховка от вечного круга: следующую порцию просим, только если `last` действительно сдвинулся вперёд. Такой ошибки в прошивке нет, но если она появится, приложение иначе спрашивало бы до разрядки аккумулятора. Цена страховки — одно сравнение.
- Отдельной работы по дублям не потребовалось: бросок из истории приходит тем же событием `roll`, что и свежий, а база отсекает повторы составным ключом. Здесь окупилось сентябрьское решение прошивки — «приложение не должно их различать».
- По окончании в журнал уходит заметка `догружено бросков с посоха: N`.

### Дальше

- Задача D2: лист персонажа и действия. Самая крупная из оставшихся и единственная, которой не нужно железо.

## 2026-09-20

### Задача D2, шаги 1 и 2: таблицы персонажа и засев

- В базе появились пять таблиц: `characters` и четыре списочные — оружие, черты, снаряжение, заклинания. Версия базы 2, миграция `MIGRATION_1_2` только создаёт новые таблицы, `rolls` не трогает. SQL в миграции не писался от руки, а скопирован из выгруженного слепка `app/schemas/.../2.json`: Room сверяет получившиеся таблицы со слепком побуквенно и роняет приложение на старте, если своя формулировка отличается хоть порядком столбцов.
- **От требования плана хранить итоги отказались.** Шаг 1 требовал класть в таблицу КБ, классовую СЛ, восприятие и скорость. Их считает движок `rules/Pf2.kt`, и вторая копия разошлась бы с первой же правкой ловкости — причём молча. В базе теперь только входные данные плюс то, что движок вывести не может: ПЗ, героизм, опыт, щит, сопротивления, языки, деньги и нагрузка.
- **Таблицы действий нет.** Атаки, испытания, навыки и восприятие движок выводит из листа сам, хранить их нечего. Своими строками остались только заклинания: их не вывести ниоткуда.
- Карты навыков (18 штук), владений бронёй и характеристик лежат в строке персонажа одной ячейкой через `CharacterConverters`, формат `STR:14,DEX:12`. Довод тот же, что у значений костей в `rolls`: они всегда читаются вместе с листом целиком, а четыре отдельные таблицы дали бы четыре соединения при каждом открытии и ни одного нового запроса. Неизвестный ключ при чтении пропускается: база, пережившая переименование навыка, потеряет один навык, а не уронит приложение.
- Поле черты названо `featGroup`, а не `group`: `group` — слово SQL, запрос с ним пришлось бы брать в кавычки. Room-то кавычки расставляет сам (как он сделал со столбцом `values` в задаче C2), но мина осталась бы лежать под первым же рукописным запросом.

### Бланк персонажа оказался машиночитаемым

- В `docs/Сильврин Хвостозвон-1(2).pdf` заполняемые поля формы: 986 полей, 213 заполненных. Перебивать лист руками не пришлось, значения вынуты скриптом (`pypdf`, `get_fields()`).
- **Бланк свежее макетов, и расходится с ними.** В макетах уровень 6, ПЗ 56/56, КБ 23, кольчуга, 65 золота, «языки не заполнены». В бланке уровень 8, ПЗ 82/36, КБ 24, деревянный доспех, 3 золота и 668 серебра, языки «Всеобщий, аммуррун». Засев сделан по бланку; макеты остаются источником разметки, но не чисел.
- Из бланка же приехали пять черт народа и родословной, шесть классовых, три черты навыков, две общие, два предмета и заговор «Наставление». Единственное, что взято из макета, — «1 действие» у заговора: такого поля в бланке нет.
- Числа правил в засеве не повторяются значением: всё, что считается, берётся из `rules/SILVRIN` — того самого эталона, на котором стоят 13 проверок движка. Иначе лист в базе и эталон разошлись бы, а тест бы этого не заметил: он проверяет эталон, а на экране показывается база.

### Проверка

- 26 юнит-тестов, из них 12 новых: `seed.toSheet()` совпадает с эталоном, броня находится в справочнике по имени, числа из бланка на месте, карты переживают запись и чтение, умение в оружии переживает запятую внутри названия.
- Тесты проверены на живучесть: в засеве временно подменили броню на кольчугу — покраснели три, в том числе Атлетика упала с +14 до +12. Кольчуга требует силу 16, у Сильврина 14, и включился штраф проверок. Ровно та ошибка, ради которой всё это и писалось.
- Миграция 1→2 на планшете ещё не проверялась: её проверит первая заливка поверх базы с бросками.

### Дальше

- Шаг 3 задачи D2 — экран листа, по вкладке за заход: каркас с чипом-переключателем и «Обзор», потом «Навыки», «Магия», «Черты и снаряжение».

## 2026-09-21

### Задача D2, шаг 3а: раздел «Персонажи» и вкладка «Обзор»

- Раздел перестал быть заглушкой. Чип-переключателя персонажа в верхней панели, четыре вкладки, а за ними лист: шапка, пять плиток защиты, шесть плиток характеристик и две карточки бросаемых строк — атаки и испытания с восприятием.
- **Ни одно число на экране не хранится.** КБ, классовая СЛ, СЛ заклинаний, скорость, испытания, восприятие, атаки и урон считаются движком по листу из базы. Из базы приходят только ПЗ, героизм и уровень — то, что движок вывести не может.
- Полоса вкладок сделана руками, а не `TabRow`: тот растягивает вкладки поровну на всю ширину, а в макете они стоят слева и каждая по ширине своего текста.
- Плитки переносятся по ширине экрана: от 900 dp пять плиток защиты и шесть характеристик встают в ряд, от 600 — по три, уже — по две. Последний ряд добивается пустотой, иначе три плитки растянулись бы шире соседних.
- Вкладка запоминается через `rememberSaveable`: без этого поворот планшета возвращал бы с «Магии» на «Обзор», см. G68.
- Появились `@Preview` на планшет и на узкий экран. Лист в превью берётся из засева, поэтому в Android Studio видны настоящие числа Сильврина, а не выдуманные.

### Столбец `shortName` у оружия

- В макете строки называются «Атака молотом» и «Урон когтями», а в базе лежит «Двуручный молот кошачьей ярости +1». Сократить это программой нельзя, поэтому у оружия появилось короткое имя в творительном падеже.
- Схема версии 2 ещё никуда не уезжала — ни на планшет, ни в коммит, — поэтому столбец добавлен прямо в неё, без версии 3 и второй миграции.

### SQL миграции теперь сверяется тестом

- Руками правленный SQL — ровно та грабля G72, из-за которой приложение падает на старте у человека с непустой базой. Проверить это на планшете дорого: нужна старая база с бросками.
- Запросы миграции переехали в список `CHARACTER_TABLES_SQL`, и `MigrationSqlTest` сверяет его со слепком `2.json` побуквенно, с точностью до пробелов. Слепок читается текстом, регулярным выражением: в юнит-тестах Android `org.json` подменён заглушкой и ничего не разбирает.
- Тест проверен на живучесть: из миграции убран столбец `shortName` — тест покраснел и показал, чем ожидаемое отличается от написанного. Ровно то, что иначе вылезло бы на планшете.

### Мелочи

- Убран размер `charactersListWidth` = 252 dp: он остался от макета, где список персонажей стоял слева колонкой. Правка макетов от 19 сентября заменила список чипом в панели, и токеном никто не пользовался.
- Засев переехал из `MainActivity.onCreate` в `CharacterViewModel`, как и было обещано.
- Где размер из макета расходится с ролью текста в `PosohTypography`, взята роль, если она названа именно этим элементом («имя персонажа», «значение плитки»). Свой размер проставлен только там, где роли нет: модификатор характеристики 22 sp и формула броска 18 sp.

### Лист переложен по замечаниям автора (вечер 21 сентября)

- **Порядок блоков изменился:** шапка, шесть характеристик, строка жизни, плитки защиты, атаки и испытания. Характеристики и здоровье подняты наверх — за столом смотрят чаще всего туда, а здоровье ещё и правят по нескольку раз за бой.
- **Уровень и героизм стали крупнее** (96 × 62 вместо 68 × 52), получили обводку и встали справа от имени одним столбцом: уровень сверху, героизм под ним, обе плитки по левому краю столбца. Кнопки «+» и «−» — справа от героизма, одна над другой, по пункту за нажатие: пунктов всего три, удержание тут только мешало бы.
- **Характеристики теперь одной строкой из шести плиток,** имена трёхбуквенные: «ВЫНОСЛИВОСТЬ» в узкую плитку не встаёт. Модификатор крупно, значение мелким и серым, у ключевой приписка «ключ.».
- **Появился блок жизни** — одной карточкой, а не четырьмя: ПЗ со шкалой, временные ПЗ, ранения, галочка «при смерти» со словом «Да» и кнопка «Полностью здоров». Всё это меняется в бою и меняется вместе, четыре отдельные карточки заставляли бы глаза прыгать по экрану в середине хода. Здоровье ушло из ряда плиток защиты, там осталось четыре.
- **Кнопки ПЗ и временных ПЗ повторяют шаг при удержании:** ПЗ бывает под сотню, набирать их по одному нажатию — занятие на весь ход. Шаги ускоряются от 120 мс к 30 мс, так и единицу поймать можно, и полсотни отмотать за пару секунд. Первый шаг делается по отпусканию, а не по нажатию: палец, опустившийся на кнопку ради прокрутки списка, не должен отнимать здоровье.
- **«Полностью здоров»** одним запросом возвращает ПЗ к максимуму, обнуляет временные ПЗ и ранения и снимает «при смерти». Одним, а не пятью: после отдыха всё это возвращается разом, и промежуточного состояния «здоров, но при смерти» быть не должно.
- Кнопка «Полностью здоров» стоит сразу за числами здоровья, в левой части блока: то, что она чинит, начинается именно с них. На узком экране блок складывается в две строки — ПЗ с кнопкой и шкалой, под ними три счётчика.

### Версия базы 3: состояние в бою

- Добавлены три столбца: `tempHp`, `wounded`, `dying`. Миграция `MIGRATION_2_3` — три `ALTER TABLE ADD COLUMN`, у каждого `DEFAULT 0`: к заполненной таблице столбец `NOT NULL` без умолчания SQLite просто не добавит, а листы в базе уже есть.
- Умолчание продублировано в `@ColumnInfo(defaultValue = "0")`: Room сверяет со слепком и умолчания тоже, столбец без него со столбцом с ним не сойдётся.
- **Счётчики меняются прибавкой прямо в SQL** (`MAX(0, MIN(maxHp, currentHp + :delta))`), а не «прочитали, посчитали, записали». Два быстрых нажатия на «+» прочитали бы одно и то же число, и одно нажатие пропало бы. Границы держит та же строка запроса — за них не выведет ни одно нажатие, откуда бы оно ни пришло.
- `MigrationSqlTest` вырос до четырёх проверок: к сверке создания таблиц добавилась сверка `ALTER`-ов со слепком версии 3 и проверка, что ни один новый столбец не остался `NOT NULL` без `DEFAULT`.

### Итог первого захода

- Вид листа автор утвердил вечером 21 сентября: «всё устраивает». Три круга правок за вечер — первый вариант по макету, потом перестановка блоков, потом мелочи с кнопками. Макеты `docs/design` всего этого не знают: в них лист шестого уровня и старый порядок блоков. До их обновления истина — приложение.
- Правка дизайна шла без промежуточных коммитов, по решению автора: коммит один, после того как вид утверждён.

## 2026-09-21, ночь: лист доведён до конца

Продолжение того же дня. Вкладка «Обзор» дособрана целиком: добавлены блоки брони, испытаний, сложностей и кнопок атак, а весь лист сведён к единому стилю. Одиннадцать кругов правок по снимкам экрана с планшета.

### Блок «КБ, доспех, навык, щит»

- Одна карточка с разделителями, четыре части: КБ силуэтом доспеха, надетый доспех галочками типа и двумя полями, владение бронёй четырьмя строками, щит.
- **Щит правится, доспех показывается.** ПЗ щита убывают от каждого блока, доспех меняется раз в несколько уровней — ему место в будущем редакторе. Разбирались по ходу дела и в самих правилах: что такое ПП (порог поломки, половина максимальных ПЗ), почему щит при блоке получает остаток урона наравне с персонажем и почему блок один за раунд — реакция.
- **Порог поломки не хранится.** У щитов он всегда половина максимума, и вторая копия разошлась бы с первой правкой.
- **Галочка «поднят».** Пока стоит, КБ щита идёт в общий класс брони; у сломанного щита галочка недоступна — по правилам он не даёт бонуса вовсе.
- Версии базы 4 и 5: `shieldHp`, `shieldMaxHp`, `shieldRaised`. ПЗ щита в бланке не заполнены, 20 назвал автор.

### Ряд «Испытания»

- Пять плиток в ряд: стойкость, реакция, воля, восприятие, инициатива. Каждая в рамке потолще — они станут кнопками в шаге 4.
- **Инициатива живёт отдельным числом.** По правилам её бросают Восприятием, но черта «Невероятная инициатива» (у Сильврина она есть) даёт +2, и вывести это неоткуда: черты у нас хранятся названиями. Версия базы 6, столбец `initiativeBonus`.

### Блок «Сложности, скорость, опыт»

- Обе СЛ и скорость показываются, опыт вводится. Скорость подписана клетками поля: 30 футов это 6 клеток.
- **Уровень при тысяче опыта приложение не поднимает**, только загорается золотым и показывает «+» рядом с уровнем. Из уровня движок выводит всё, а ПЗ, владения и черты хранятся и меняются по книге руками: кнопка «повысить» дала бы персонажа, поднявшегося наполовину.
- Поле опыта — первое на листе, куда пишут руками. Только цифры, «Готово» на клавиатуре и тычок мимо поля снимают курсор.

### Кнопки атак

- На каждое оружие строка из двух кнопок: слева атака, справа урон. Значки владения и типа урона вставлены прямо в строку названия — тогда у длинного имени они переносятся вместе с ним.
- Версии базы 7 и 8: тип урона (`damageType`) и короткие свойства (`shortTraits`). Тип урона когтей взят из галочки бланка `WEAPON SLASHING`, у молота галочек нет — дробящее по книге. Молот переименован в «Двуручный молот +1» по уточнению автора.
- Последняя строка — магическая атака. Пары у неё нет: урон у каждого заклинания свой. Правая кнопка ведёт на вкладку «Магия» и **работает уже сейчас** — единственное живое нажатие на листе.

### Единый стиль

- **Весь лист переведён на один шрифт Onest**, включая числа и знаки «+» и «−». Literata осталась только на «Бросках». Раньше числа набирались ей, и число с подписью рядом читались как из разных документов.
- Три кегля чисел (26 / 15 / 12), один кегль текста (12) в трёх ролях, весь текст чёрный. Толщина рамки говорит, можно ли нажать: одна точка — показометр, две — кнопка.
- Правила записаны в `docs/design/STYLE.md`, в шапке `SCREENS.md` стоит предупреждение, что лист он описывает устаревшим.

### Четыре правки данных в миграциях подряд

Засев срабатывает только на пустой базе, а лист Сильврина в ней давно лежит. Поэтому версии 5, 6, 7 и 8 не только добавляли столбцы, но и чинили уже записанное: ПЗ щита, прибавку к инициативе, тип урона, имя молота, короткие свойства. Каждый раз с узким условием — например, двойка к инициативе досталась только тем, у кого в чертах есть «Невероятная инициатива».

**Это сигнал, а не приём.** Четыре раза за вечер — значит назрел лист снаряжения с ручной правкой оружия и щита; тогда догонять засев миграциями больше не придётся.

### Грабли

Новые: G77 (растянутая подпись в невзвешенной колонке), G78 (`size` параметра перекрывает `size` холста), G79 (одноимённые composable в одном пакете), G80 (правка данных в миграции как признак недостающего редактора). Подробности в базе знаний.

### Итог ночи

- Вкладка «Обзор» закончена. Осталось только нажатие на кнопках — это шаг 4 задачи D2.
- База доехала с версии 3 до 8, все переезды сверяются тестом со слепками. Тестов 39, все зелёные.

## 2026-09-22: сохранение персонажа

Первая функция, которой не было ни в плане, ни в макетах. За столом лист меняется весь вечер, и откатиться было некуда.

### Как сделано

- В верхней панели рядом с чипом персонажа — «Сохранить» и «Загрузить».
- **Сохранение — копия персонажа в той же таблице**, а не отдельная запись с листом внутри. У `characters` появились `saveName`, `savedAt` и `saveOf`: у живого листа они пусты, у копии заполнены. Части (оружие, черты, предметы, заклинания) копируются вместе с ним.
  Причина выбора: Room копирует строку с частями сам, сериализовать ничего не надо, и сохранение не протухнет от следующей версии схемы. Альтернатива — лист в JSON отдельной таблицей — потребовала бы своего сериализатора, а первое же новое поле сделало бы старые сохранения неполными.
  Цена: во все запросы списков добавился `WHERE saveName IS NULL`, иначе копии полезли бы в чип выбора персонажа и в засев.
- Название по умолчанию — «Имя ГГГГ-ММ-ДД ЧЧ:ММ:СС». Занятое имя не отвергается после нажатия, а сразу гасит кнопку «Сохранить»: отказ виден до того, как человек решил, что дело сделано.
- «Загрузить» сверяет открытый лист со всеми его сохранениями. Не совпал ни с одним — спрашивает «Текущее состояние персонажа не сохранено! Продолжить?». Дальше список сохранений, свежие сверху. **Сам выбор строки пока ничего не делает** — загрузка отдельной задачей, мёртвый выбор честнее придуманного.

### Правило, которое важнее самой функции

Сохранение копирует **ровно те части листа, что перечислены руками** в `saveCopy` и `sameAs`. Отсюда два правила на будущее, и они записаны прямо в коде — в `CharacterParts.kt`, `CharacterRepository.kt` и у списка вкладок в `CharacterScreen.kt`:

1. **Новый столбец** у персонажа или у части попадёт в сохранение сам: копируется вся строка.
2. **Новая таблица-часть** сама никуда не попадёт. Её надо вписать в три места: `CharacterSheet`, `saveCopy` и `sameAs`.

Чтобы это не осталось благим пожеланием, поставлена ловушка: тест считает части листа и падает, когда их становится больше пяти, с текстом «впиши новую в saveCopy и sameAs». Потеря иначе была бы молчаливой — сохранение просто не взяло бы новую часть, и заметили бы это только при первой загрузке.

То же касается вкладок: «Навыки», «Магия» и «Черты» будут заводить свои данные, и каждая обязана доехать до сохранения.

### Сверка «состояние сохранено»

Сравнивается лист целиком — паспорт, ПЗ, опыт, поднятый щит, все части, — кроме номеров строк и подписи сохранения. Ошибка тут стоит дорого в обе стороны: пропустишь разницу — человек молча потеряет ход боя, найдёшь лишнюю — будешь спрашивать каждый раз. Поэтому на сверку пять тестов: копия с другим номером совпадает, а потерянный ПЗ, поднятый щит и пропавшее оружие — нет.

### Итог

- Версия базы 9. Тестов 46, все зелёные.
- Мелочь на память: два сохранения в одну секунду получат одинаковое имя по умолчанию, и второе упрётся в «название занято». Дописать слово руками честнее, чем молча подставлять «(2)».

### Дальше

- Шаг 3б: вкладка «Навыки», две колонки, обученные по убыванию модификатора, нетренированные справа, карточка-легенда со степенями владения.
- Сама загрузка сохранения: выбор строки в списке пока ничего не делает.
- Отдельной задачей назрел лист снаряжения: оружие, щит, доспех с ручной правкой.

## 2026-09-24 … 2026-09-25: справочник черт навыков и общих черт

- Получен пассивный зуммер (пищалка) 12085, позиция 7 в [hardware/bom.md](hardware/bom.md). Ждём: дисплей, PCF8574 ×2, тумблер, кнопки.

### Что сделано

- Справочник черт `app/app/src/main/assets/feats.json` вырос со 106 до 256 черт: добавлены 149 черт навыков и одна общая (Thorough Search) с pf2.ru, все в легаси-версии. Черты без легаси-версии (страница `?legacy=true` отвечает «не найдено») не берутся — таких 26 во вкладках и ещё несколько проверены руками.
- У черты появилось поле `skills` — к каким навыкам она относится, названиями из листа (`Skill` в `rules/Pf2.kt`). Берётся из поля «навык» списка на сайте, при прочерке — из требований черты. «Выступление» сайта записывается как «Исполнение», «Warfare Знание» — как «Знание». Навык ищется только с начала слова: иначе «Знание» находилось внутри «Распознания заклинаний». У черт «на любой навык» (Assurance, Skill Training) список пуст. Навыки есть у 145 черт. Приложение поле пока не читает.
- Сборщик `tools/fetch_feats.py`:
  - разворачивает строку `https://pf2.ru/feats?tab=skill` из `tools/feat-urls.txt` во все черты вкладки;
  - ключ `--saved docs/feats` берёт страницы только из сохранённых браузером файлов, к сайту не обращаясь. Понимает обычное сохранение и расширение SingleFile (оно убирает кавычки у атрибутов, сборщик возвращает их на место);
  - уже собранные черты не теряются, даже если их ссылок нет в текущем списке;
  - подробный вывод: счётчик страниц, что взято, что пропущено; Ctrl+C останавливает сбор без потери собранного.

### Что не получилось и почему

- **Сбор с сайта программой — запрещён владельцем.** Первый прогон шёл по запросу в секунду; после ~140 страниц сайт стал отвечать 429, а затем показал «Обнаружена подозрительная активность»: адрес забанен системой распознавания ботов, владелец просит не парсить сайт и писать ему запрос на данные. Пауза 3–7 с и смена VPN не помогают и не нужны: правило владельца важнее. Страницы сохранялись руками в браузере, сборщик разбирает их из папки.
- Первый прогон упал на таймауте и потерял всё собранное: справочник писался только в конце. Исправлено — повтор при таймауте, остановка с записью собранного.
- Разрывы строк посреди фраз («что и для ⏎ Лечения ранений») примерно у 40 % черт, и у старых тоже: это переносы из разметки сайта. Не исправлено, решить отдельно.
- Три строки листа Сильврин не находят описания, потому что это не черты: «Сумеречное зрение», «Приземление на ноги» (способности народа) и «Когтистый котолюд» (родословная). Нужны страницы народа и родословной.

### Дальше

- Понедельник, 2026-09-28: продолжить разработку.
- Написать владельцу pf2.ru запрос на данные черт.
- Решить про разрывы строк в текстах черт и про описания способностей народа и родословной.

## 2026-10-22: все компоненты на руках, корпус без 3D-печати

- Получены дисплей ST7789, два расширителя PCF8574, выключатель питания и тактовые кнопки (точные даты получения не записаны). Из электроники ждать больше нечего. Не пришёл только силиконовый молд шара (заказан 2026-09-11).
- Решение: корпус делается из ПВХ-труб и фитингов ручным инструментом, без 3D-печати. Оправа — муфта 25→32 мм, рукоять — отрезок трубы 50 мм с переходниками 50→25, как в вариантах «без принтера» из SPEC. Картридж под дисплей и кольцо без печати ещё предстоит придумать (задача 14). Записано в SPEC, раздел 4.
- Дальше: этап B плана на макетной плате, начиная с задачи 3 (дисплей). Гребёнку к дисплею нужно припаять.
- Проверено по факту: выключатель — двухпозиционный тумблер (в рукояти круглое отверстие, по характеристикам 6 мм); кнопки без фиксации, возвращаются сами.

## 2026-10-26: расширители PCF8574 и первая кнопка кости

### Что сделано

- Расширители проверены по надписи на чипе: PCF8574T, адреса 0x20 (кости) и 0x21 (служебные). На модуле стоят подтяжки шины 1 кОм («102»), с двумя модулями и часами на шине работает.
- Решено по служебным кнопкам (SPEC, раздел 2.5): Сброс, Повтор, Свет, Тихо и четыре кнопки меню — ОК, ◄, ►, Отмена. Все восемь на втором расширителе, всего кнопок 16. «Удача» и «неудача» показывают итог крупно, оба броска снизу через запятую.
- Заказаны диод 1N4148 для пищалки и гребёнка «папа» под шину земли кнопок в рукояти.
- На макетке: оба расширителя на шине I2C, второй цепочкой в выход первого, INT не подключён. Одна кнопка между входом первого расширителя и землёй.
- Прошивка 0.7.3, `buttons.h`: опрос расширителя костей по шине раз в 10 мс, дребезг 30 мс. Кнопка кости взводит; та же кость добавляет ещё одну, после 10 снова 1; другая кость начинает заново. Удар 0,3 с после нажатия не считается.
- Проверено: кнопка, переставленная на разные входы P0…P7, взводит свою кость; повторные нажатия, бросок после взвода, взвод после результата.

### Что не получилось и почему

- 0.7.0: взвод кнопкой снимался в момент нажатия. Таймаут взвода считался от времени начала оборота цикла, а кнопка взводит позже в том же обороте — разность беззнаковых чисел уходила через ноль. Исправлено в 0.7.1.
- Сообщение «после результата кнопка не взводит» на 0.7.2 не повторилось, причина не найдена.

### Дальше

- Шаг 1 плана сборки: прошивка со звуком, без мигания светодиодом на ножке 8. Потом подключение пищалки.
- Остальные 7 кнопок костей, затем служебные кнопки и кнопки меню.

## 2026-10-26: пищалка и звук

### Что сделано

- Спаян блок пищалки: S8050, резистор 470 Ом в базу, зуммер 12085 от 5 В, диод 1N4148 поперёк зуммера (полоска к 5 В).
- Прошивка 0.8.0, `sound.h`: звук через ШИМ LEDC, в тишине на ножке 8 ноль. Мигание светодиодом платы убрано — синий светодиод теперь горит постоянно. Писк при старте, щелчок на нажатие кнопки, тик на каждой смене числа в барабане, аккорд после броска, фанфара на 20 и грустный звук на 1 по d20.
- Проверено: звук работает.
- Схемы `hardware/schematic/wiring.svg` и `power.svg`, `hardware/wiring.md`, SPEC и план приведены к собранному: INT не подключается, 16 кнопок, диод, шина земли кнопок, замеры MT3608.

### Дальше

- Остальные 7 кнопок костей (прошивка готова).
- Служебные кнопки и кнопки меню: прошивка.

## 2026-10-27: шины питания, кольцо при старте

### Что сделано

- Часы DS3231 перенесены в цепочку I2C за расширителями: плата → PCF8574 №1 → №2 → часы, часы на выходе №2 по подписям. Схема `wiring.svg` перерисована.
- Шины питания и земли из гребёнки PLS-40: GND 30 штырей (общая, вместе с кнопками), 5 В 7, 3,3 В 7. Статусы в `bom.md` — только «не заказано», «заказано», «получено».
- Прошивка 0.9.0, `lights.h`: кольцо WS2812B гасится первым делом в `setup()`, затем огненная вспышка около 1,8 с. Потолок яркости кольца 100 из 255: огонь тянет около 0,15 А. При старте в журнал пишется причина перезапуска — чтобы отличить просадку питания от зависания.

### Что не получилось и почему

- Кольцо вспыхивает белым при каждом включении. Ножка GPIO21 — это ещё и TX порта UART0, загрузчик платы печатает туда служебный текст, и кольцо принимает его за цвета. Помешать загрузчику нельзя, вспышку прикрывает стартовая анимация. Записано в `wiring.md`.

## 2026-10-28: вспышки, звуки, сон экрана

### Что сделано

- Прошивка 0.11.0: вспышка кольца на итоге броска — белая короткая на обычный бросок, золотая на 20 и красная мерцающая на 1 по d20. Вспышка не останавливает посох, кадры дорисовываются из главного цикла и из пауз между нотами.
- Новые звуки: писк включения 1 кГц, «пуньк» на обычный итог, «вжух-блик» на 20. На 1 по d20 сначала был грустный тромбон, потом (851d35a) фраза «Hello darkness, my old friend» из «The Sound of Silence», красная вспышка удлинена до 3,5 с под неё.
- Тестовый режим `TEST_D20_CYCLE` в `config.h`: броски 1d20 по кругу «случайный, 20, случайный, 1», чтобы проверять вспышки и звуки за четыре броска. В коммите 12e1f6a он ушёл включённым, хотя в описании сказано «выключен»; оставлен включённым по решению автора до конца проверок.
- Прошивка 0.12.0, решения автора: экран засыпает через 2 мин без действий, и у взведённого посоха тоже; взвод больше не спадает сам; результат возвращается к часам через 1,5 мин.
- Прошивка 0.13.0: опрос второго расширителя 0x21 — короткое нажатие при отпускании, долгое на второй секунде удержания. Во сне служебная кнопка только будит экран.

## 2026-10-29: служебные кнопки, свет, удача, история

### Что сделано

- Прошивка 0.14.0: «Сброс» снимает взвод (долгое гасит экран), «Повтор» взводит последний бросок из истории во флеш — и после перезапуска тоже, «Тихо» выключает звук, помнится во флеш, в строке состояния перечёркнутый динамик.
- 0.14.1: заряд пишется в журнал при старте и при изменении на 5 %, а не каждые 10 с.
- 0.15.0: «Свет» — свечение кристалла огнём, режимы выкл / тускло / ярко, долгое нажатие меняет палитру из пяти. Свечение гаснет только кнопкой, сон экрана его не трогает, вспышки бросков идут поверх. 0.15.1: палитры стали контрастнее.
- 0.16.0: долгий «Повтор» — 1d20 с удачей, следующее долгое — с неудачей. FORTUNE зелёным, MISFORTUNE красным, на результате оба броска «14, 7». На планшет — поле `adv` по плану D4, в истории — байт `flags` без смены формата.
- 0.17.0–0.17.1: ◄ ► листают 20 последних бросков из флеш, по 4 на экран, выбранная строка на тёмно-синем фоне.
- Конденсатор 1000 мкФ у кольца убран, документы приведены к собранному.
- Теоретический расчёт автономности: от 4–5 вечеров с ярким белым свечением до ~12 с тусклым одним цветом; замеры — после всех работ.
- Проверено на макетке: все кнопки по таблицам проверки, свет, удача и неудача, история.

### Что не получилось и почему

- **Щелчок кости пропадал, когда она будила спящий экран.** По коду щелчок звучал до пробуждения, но экран, проснувшийся сразу за двухмиллисекундным щелчком, его глушил. Временная отладка с замером сдвинула время и щелчок вернула, причину в железе не нашли. Лечение (0.14.1): сначала будим экран, потом щёлкаем.
- **От аккумулятора посох не включался:** кольцо коротко моргало белым, и всё. На выходе TP4056 0,9 В при 4,1 В на аккумуляторе — сработала защита модуля (грабля из 2026-09-17). Без кольца посох включался. Причина — конденсатор 1000 мкФ у кольца: у повышающего MT3608 вход соединён с выходом через дроссель и диод, и пустой конденсатор при включении тумблера заряжается прямо из аккумулятора броском в несколько ампер. Конденсатор убран, для длинных проводов в собранном посохе запасной вариант — через резистор 470 Ом с диодом 1N4148 (`wiring.md`, «Питание»).
- **Часы отставали почти на 19 часов.** Флага потери питания нет, часы идут верно (между двумя запусками на часах 9 мин 47 с, столько же на деле), отставание постоянное. Значит, неверное время было записано один раз; приложение шлёт время планшета, так что, скорее всего, это запасное время сборки прошивки при какой-то потере питания часов. Точно не установлено. Добавлена проверка бита EOSC (6536b63), он оказался не взведён.
- Голубая и фиолетовая палитры почти не мерцали: общий множитель яркости от накала съедал разницу между цветами. Исправлено в 0.15.1.
- При старте в журнале `во флеш кость d4 дважды, беру значения по умолчанию`: таблица костей по кнопкам во флеш отвергнута. Откуда она такая, не разобрано.

### Дальше

- Меню на «ОК»: яркость экрана, громкость, время до засыпания.
- Пометка на экране часов, пока время не подтверждено планшетом.
- Разобрать таблицу костей с двумя d4.
- Удача и неудача в ленте приложения (D4, шаг 3).
- Перед игрой: `TEST_D20_CYCLE = false`.
- После всех работ: замер автономности от аккумулятора.
