mrTelnor/wizards-staff/firmware/wizards_staff/sound.h

#pragma once
#include <Arduino.h>
#include <Preferences.h>
#include "config.h"
#include "lights.h"

// Пищалка: электромагнитный зуммер 12085 через транзистор S8050 на ножке PIN_BUZZER.
// Зуммер пассивный, сам не пищит: звук даёт ШИМ на нужной частоте.
//
// Главное правило: в тишине на ножке НОЛЬ. Единица открывает транзистор, и через
// катушку постоянно идёт около 120 мА: зуммер греется и сажает аккумулятор.
// Поэтому управляем ножкой сами через LEDC, а не через tone(): после tone() состояние
// ножки зависит от версии пакета плат, а ledcWrite(…, 0) всегда даёт ноль.
//
// На этой же ножке у SuperMini синий светодиод платы, он горит при нуле. Значит,
// в тишине он горит постоянно, а во время звука мерцает. В закрытой рукояти не видно.
//
// Все звуки блокирующие: самый длинный, фраза на провал, идёт около 3,5 с и звучит после
// броска, когда датчик удара всё равно не слушается (STRIKE_COOLDOWN_MS, 5 с). Ждут они через
// ringWait, а не delay: звук итога и фанфары звучат под вспышку кольца, и она не должна замирать.

bool soundEnabled = true;   // выключает кнопка «Тихо»; помнится во флеш, см. soundLoad

// Около этой частоты зуммер 12085 звучит громче всего.
const uint32_t SOUND_TICK_HZ  = 2700;
const uint32_t SOUND_CLICK_HZ = 4000;

// Ставит ножку пищалки в ноль и готовит ШИМ. Вызывать самой первой строкой setup():
// пока ножка не задана, она висит в воздухе, и транзистор может приоткрыться.
void soundBegin() {
  pinMode(PIN_BUZZER, OUTPUT);
  digitalWrite(PIN_BUZZER, LOW);
  ledcAttach(PIN_BUZZER, SOUND_TICK_HZ, 10);
  ledcWrite(PIN_BUZZER, 0);
}

// Достаёт из флеш, включён ли звук. Выключил перед тихой игрой — посох молчит и после
// тумблера, пока не нажмёшь «Тихо» снова. Вызывать в setup() до первого звука.
void soundLoad() {
  Preferences prefs;
  prefs.begin("staff", true);
  soundEnabled = prefs.getBool("sound", true);
  prefs.end();
}

// Включает или выключает звук и запоминает это во флеш. Флеш пишется только
// по нажатию «Тихо», так что износ ей не грозит.
void soundSetEnabled(bool on) {
  soundEnabled = on;
  Preferences prefs;
  prefs.begin("staff", false);
  prefs.putBool("sound", on);
  prefs.end();
}

// Громкость из меню, % от громкого (VOLUME_LEVELS в config.h). Ставит её settingsApply().
uint8_t soundVolumePct = 100;

// Громкость в переливах: заполнение ШИМ от 0 (тишина) до 511 (половина периода, громче всего).
// У электромагнитного зуммера разница не так велика, как у динамика, но затихание слышно.
const uint32_t SOUND_VOL_MAX = 511;

// Заполнение ШИМ с учётом громкости из меню: vol от 0 до SOUND_VOL_MAX.
uint32_t soundDuty(uint32_t vol) {
  return vol * soundVolumePct / 100;
}

// Одна нота: частота в герцах, длительность в миллисекундах. После неё ножка снова в нуле.
void soundNote(uint32_t hz, unsigned long ms) {
  if (!soundEnabled) return;
  ledcWriteTone(PIN_BUZZER, hz);                  // ставит частоту и заполнение 50 %...
  ledcWrite(PIN_BUZZER, soundDuty(SOUND_VOL_MAX)); // ...а громкость задаём по меню
  ringWait(ms);
  ledcWrite(PIN_BUZZER, 0);
}

// Пауза между нотами. Отдельно, чтобы при выключенном звуке не ждать впустую.
void soundRest(unsigned long ms) {
  if (soundEnabled) ringWait(ms);
}

// Шаг, с которым меняются частота и громкость в переливах ниже.
const unsigned long SOUND_STEP_MS = 3;

// Плавно ведёт звук от одной частоты и громкости к другой за ms миллисекунд.
// jitter — случайный разброс частоты в процентах на каждом шаге: при 20–30 % тон
// рассыпается в шипение, так звучит взмах клинка.
void soundSweep(uint32_t fromHz, uint32_t toHz, unsigned long ms,
                uint32_t fromVol, uint32_t toVol, int jitter = 0) {
  if (!soundEnabled) return;
  for (unsigned long t = 0; t < ms; t += SOUND_STEP_MS) {
    long hz  = fromHz  + ((long)toHz  - (long)fromHz)  * (long)t / (long)ms;
    long vol = fromVol + ((long)toVol - (long)fromVol) * (long)t / (long)ms;
    if (jitter) hz = hz * random(100 - jitter, 101 + jitter) / 100;
    ledcWriteTone(PIN_BUZZER, hz);           // ставит частоту и заполнение 50 %...
    ledcWrite(PIN_BUZZER, soundDuty(vol));   // ...а громкость задаём сами, с поправкой на меню
    ringWait(SOUND_STEP_MS);
  }
  ledcWrite(PIN_BUZZER, 0);
}

// Дрожащий тон: частота качается вокруг hz на depth герц rate раз в секунду, громкость
// тем временем идёт от fromVol к toVol. Медленное качание — певучее вибрато,
// быстрое — мерцание отблеска.
void soundVibrato(uint32_t hz, uint32_t depth, float rate, unsigned long ms,
                  uint32_t fromVol, uint32_t toVol) {
  if (!soundEnabled) return;
  for (unsigned long t = 0; t < ms; t += SOUND_STEP_MS) {
    long f   = hz + depth * sinf(2 * PI * rate * t / 1000.0f);
    long vol = fromVol + ((long)toVol - (long)fromVol) * (long)t / (long)ms;
    ledcWriteTone(PIN_BUZZER, f);
    ledcWrite(PIN_BUZZER, soundDuty(vol));
    ringWait(SOUND_STEP_MS);
  }
  ledcWrite(PIN_BUZZER, 0);
}

// Писк при включении, как у компьютера, прошедшего самопроверку (POST): один короткий
// ровный сигнал около 1 кГц. Пищалка на этой частоте тише, чем на 2,7 кГц, зато звук узнаётся.
void soundStartup() {
  soundNote(1000, 200);
}

// Тихий щелчок на нажатие кнопки: подтверждение, что нажатие засчитано.
void soundClick() {
  soundNote(SOUND_CLICK_HZ, 2);
}

// Тик барабана: на каждой смене числа во время броска.
void soundTick() {
  soundNote(SOUND_TICK_HZ, 3);
}

// «Пуньк» после обычного броска: кубик стукнул и остановился. Тон за долю секунды падает
// вниз и гаснет, около 0,13 с. Совсем низко пищалка не может: ниже 1 кГц она почти
// не слышна, поэтому удар начинается с 1,6 кГц и только хвост уходит к 500 Гц.
void soundChord() {
  soundSweep(1600, 700, 60, SOUND_VOL_MAX, 250);   // «пу»: удар, тон резко падает
  soundSweep(700, 500, 70, 250, 0);                // «ньк»: короткий глухой хвост
}

// «Вжух-блик» на 20 по d20, около 0,85 с: резкий взмах клинка, переходящий в сияющий отблеск.
void soundCrit() {
  // Вжух: шипящий взмах снизу вверх, громкость нарастает к концу удара.
  soundSweep(1200, 4500, 150, 120, SOUND_VOL_MAX, 25);
  soundRest(50);
  // Блик: три звонкие капли вверх (до, ми, соль восьмой октавы)...
  soundNote(4186, 30);  soundRest(20);
  soundNote(5274, 30);  soundRest(20);
  soundNote(6272, 50);
  // ...и отблеск: высокий тон быстро мерцает и тает.
  soundVibrato(5274, 300, 30, 500, SOUND_VOL_MAX, 10);
}

// На 1 по d20, около 3,5 с: фраза «Hello darkness, my old friend» из «The Sound of Silence».
// Шесть восьмых ре-ре-фа-фа-ля-ля и целая нота соль на «friend», которая дрожит и затихает.
// Сыграно на три октавы выше песни: ниже 1 кГц наша пищалка почти не слышна.
// Паузы перед фразой в такте пропущены, чтобы она звучала сразу за вспышкой.
void soundFail() {
  const uint32_t phrase[6] = { 2349, 2349, 2794, 2794, 3520, 3520 };   // ре, ре, фа, фа, ля, ля седьмой октавы
  for (int i = 0; i < 6; i++) {
    soundSweep(phrase[i], phrase[i], 230, SOUND_VOL_MAX, 300);   // восьмая, слегка затухает, как пропетый слог
    soundRest(30);                                               // зазор, чтобы одинаковые ноты не слились
  }
  soundVibrato(3136, 30, 5, 2000, SOUND_VOL_MAX, 30);   // «friend»: соль целой нотой, с вибрато и затиханием
}
