mrTelnor/wizards-staff/firmware/wizards_staff/help.h

#pragma once

// Инструкция на посохе: пункт меню «Инструкция» (menu.h). Здесь только тексты страниц,
// рисует их menu.h.
//
// Страница — заголовок и до HELP_LINES строк. Строка не длиннее 19 знаков: при кегле 2
// это 228 точек, с отступом 8 слева как раз влезает в 240. Знаки считаются буквами,
// а не байтами (русская буква в UTF-8 два байта, G67). Пустые строки в конце — nullptr.
// Тексты сверены с поведением прошивки и SPEC 2.1–2.5 (2026-10-29); поменялись
// кнопки — поправить и здесь. У каждой служебной кнопки своя страница (2026-10-30).

const int HELP_LINES = 8;

struct HelpPage {
  const char* title;
  const char* lines[HELP_LINES];
};

const HelpPage HELP_PAGES[] = {
  { "Кости", {
    "Нажми кость -",
    "посох взведён,",
    "например 1d20.",
    "Ещё раз ту же:",
    "+1 кость, до 10.",
    "11-е нажатие - 1.",
    "Другая кость -",
    "взвод заново." } },
  { "Удар", {
    "Стукни посохом",
    "об пол - бросок.",
    "Удар считается,",
    "только если посох",
    "взведён. После",
    "броска взвод снят,",
    "сам не спадает.",
    nullptr } },
  { "Повтор", {
    "Коротко: взвести",
    "прошлый бросок.",
    "Долго: 1d20 с",
    "удачей, ещё раз -",
    "неудача.",
    "Удача: лучший из 2,",
    "неудача - худший.",
    "Кость: снять режим." } },
  { "Сброс", {
    "Коротко: снять",
    "взвод, к часам.",
    "(В меню - выход.)",
    "Долго: погасить",
    "экран.",
    nullptr, nullptr, nullptr } },
  { "Тихо", {
    "Коротко: звук",
    "вкл / выкл.",
    "Без звука вверху",
    "экрана значок.",
    nullptr, nullptr, nullptr, nullptr } },
  { "Свет", {
    "Коротко: выкл,",
    "тускло, ярко.",
    "Долго: другой",
    "цвет огня (если",
    "выкл - включит).",
    "Сон экрана свет",
    "не гасит.",
    nullptr } },
  { "Кнопки меню", {
    "ОК - меню.",
    "◄ - история",
    "бросков, ◄ ► -",
    "листать.",
    "Отмена - назад.",
    nullptr, nullptr, nullptr } },
  { "Меню", {
    "◄ ► - пункт,",
    "по кругу.",
    "ОК - открыть.",
    "В пункте ◄ ► -",
    "значение, ОК -",
    "сохранить,",
    "Отмена - вернуть.",
    nullptr } },
};

const int HELP_PAGE_COUNT = sizeof(HELP_PAGES) / sizeof(HELP_PAGES[0]);
