mrTelnor/wizards-staff/(commit log)

2026-09-16 feat(repo): структура репозитория, среда Arduino IDE, питание от аккумулятора, схемы
    Первый коммит проекта «Посох мага»: реквизит-дайсы для D&D на ESP32-C3 SuperMini.
    - README, ТЗ (SPEC.md), журнал сборки за 2026-09-03 … 2026-09-17, лицензии MIT и CC BY-SA 4.0.
    - firmware: описание среды (IDE 2.3.10, esp32 3.3.11, библиотеки), скетч wizards_staff
    с config.h (все ножки и тайминги) и battery.h (замер заряда через делитель),
    временный тест питания в wizards_staff.ino.
    - firmw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
2026-09-17 chore(app): пустой проект Android Studio
    Kotlin, Jetpack Compose, minSdk 29 (Android 10), targetSdk 37, AGP 9.4, Gradle 9.6.
    Пакет ru.telnor.wizardsstaff. Собирается и запускается на планшете
    HUAWEI MatePad SE 11 (HarmonyOS 2.0), основном устройстве для приложения.
    В журнале запись о старте этапа 2.
2026-09-17 feat(firmware): BLE, сервис UART и заряд, команды info и time
    Посох виден по Bluetooth как WizardsStaff. Библиотеки NimBLE-Arduino 2.5.1
    и ArduinoJson 7.4.3, схема разделов Minimal SPIFFS (прошивка 611 КБ).
    - ble.h: сервис Nordic UART (RX команды, TX события) и стандартный Battery Service,
    JSON по строке, разрезка на пакеты по согласованному MTU, команда считается
    законченной по закрывающей скобке, чтобы работать из любого BLE-терминала.
    - wizards_staff.ino: временн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
2026-09-17 feat(firmware): датчик удара SW-420, броски по удару и по команде с планшета
    - strike.h: фильтр силы удара. Переключения выхода датчика считаются в окне
    STRIKE_WINDOW_MS (100 мс), удар засчитывается от STRIKE_MIN_EDGES (10)
    переключений; перемещение посоха даёт единицы и отсекается. Каждая пачка
    печатается в Serial для подбора порога. После броска пауза STRIKE_COOLDOWN_MS (5 с).
    - dice.h: бросок NdX на аппаратном генераторе, разбор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
2026-09-17 feat(firmware): часы DS3231 и взвод посоха из приложения
    - rtc.h: свой драйвер DS3231 на Wire, без внешней библиотеки
    - время в часах и в протоколе по UTC, в config.h смещение пояса для печати
    - при потере питания часы получают время сборки, точное приходит командой time
    - команда time теперь пишет время в часы, ts в броске стал настоящим
    - команды arm и disarm: приложение взводит посох на нужный кубик
    - невзведённый пос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
2026-09-17 feat(app): подключение к посоху, лента бросков и взвод
    - тема и шрифты из макетов docs/design перенесены в проект
    - ble/StaffBle.kt: поиск, подключение, уведомления, очередь команд GATT
    - ble/Protocol.kt: разбор событий и сборка команд посоха
    - StaffViewModel.kt: лента бросков в памяти, заряд, состояние взвода
    - экран «Посох»: поиск, подключение, заряд, версия прошивки
    - экран «Броски»: последний бросок, лента, криты, карт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
2026-09-17 feat(firmware): очередь команд, время в info и диагностика датчика по BLE
    - ble.h: очередь принятых команд на шесть штук
    - без неё вторая команда подряд терялась: приложение шлёт info и time,
    time пропадала целиком и часы не подводились
    - в ответ info добавлено поле ts со временем посоха
    - событие log: итог пачки переключений датчика, удар без взвода,
    удар в паузе после броска, спавший взвод
    - strike.h отдаёт чис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
2026-09-17 feat(app): экран логов, анимация броска и правки разметки
    - экран «Логи посоха»: обмен в обе стороны, поиск, автопрокрутка,
    отправка команды руками, сохранение в файл через системный выбор места
    - справочник команд посоха с примерами ответов в разделе «Посох»
    - расхождение часов посоха с планшетом и кнопка синхронизации
    - барабан результата: числа прокручиваются и останавливаются на в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
2026-09-17 docs: журнал за 17 и 18 сентября
2026-09-18 feat(firmware): опознание посоха, сквозные номера бросков, история во флеш
    - identity.h: staffId, случайное 32-битное число в NVS, придумывается при первом
    старте. Нужен помимо MAC потому, что счётчик номеров лежит в той же NVS: если она
    потрётся, номер посоха сменится вместе со сброшенным счётчиком, и приложение
    поймёт, что нумерация началась заново. В ответ info добавлены staffId и mac.
    - history.h: кольцевой фай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
2026-09-18 feat(firmware,app): единый журнал, кости во флеш, догрузка истории порциями
    Прошивка:
    - log.h: общий вид служебных сообщений «ГГГГ-ММ-ДД ЧЧ:ММ:СС.ммм МОДУЛЬ уровень:
    текст». Одна функция на всю прошивку, она же отдаёт строку в приложение.
    Модули латиницей: BOOT, TIME, FS, HISTORY, ID, BLE, DICE, STRIKE, CHARGE,
    ROLL, BATTERY. Уровни info, warn, ERROR!.
    - Буфер на 30 строк: пока планшета нет, журнал копится и выливается при
    подключени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
    [RollsScreen.kt, ble.h]
2026-09-18 fix(app): клавиатура больше не закрывает поле ввода команд
    windowSoftInputMode="adjustResize" в манифесте перестал действовать в тот момент,
    когда включили enableEdgeToEdge(): она отдаёт приложению всю площадь экрана вместе
    с системными полосами, и автоматическая подгонка окна под клавиатуру уходит вместе
    с ней. Про клавиатуру приложение должно узнавать само.
    - imePadding() в каркасе приложения, а не на экране жу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
2026-09-18 feat(app): иконка приложения, пиксельный посох
    - Значки всех плотностей собраны из app/icon/icon-512.png методом «ближайшего
    соседа»: обычное сглаживание замылило бы пиксель-арт.
    - Адаптивная иконка: передний слой занимает центральные 72 dp из 108, то есть
    зону, которую маска лаунчера не обрезает ни при какой форме значка. Фон —
    сплошной #070C14, цвет рамки самого рисунка, поэтому стык не виден.
    - Мон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
2026-09-19 fix(firmware): кости до d1000, человеческие отказы, журнал без буфера старта
    - Разбор команд arm и roll терял грани больше 255. Оператор | у ArduinoJson
    смотрит на тип значения справа и отдаёт его, если присланное число в этот
    тип не влезает, а DEFAULT_SIDES был uint8_t. Запрос d1000 молча становился
    d20, а d1001 не получал отказа: до проверки границ d уже был двадцаткой.
    Константа стала uint16_t, в обоих местах разбора доб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
    [ble.h, config.h, log.h, wizards_staff.ino]
2026-09-19 fix(app): состояние при повороте, клавиатура не сжимает разметку
    - Раздел и флаг «открыты логи» лежали в remember, а поворот планшета
    пересоздаёт активность: из логов приложение возвращалось в «Броски».
    Теперь rememberSaveable. Тем же закрыты флаги двух диалогов — диалог
    разрешений при повороте просто исчезал.
    - imePadding на каркасе подгонял высоту окна под клавиатуру, и разметка
    сжималась: журн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
    [RollsScreen.kt]
2026-09-19 docs: этап 2 в ТЗ, файлы прошивки в README, цифры питания и решения
    - SPEC.md, раздел 7а: назывался «Идеи на потом» и описывал этап 2 как
    незапланированный, хотя тот идёт с 17 сентября и наполовину сделан.
    Переименован в «Этап 2: связь с планшетом и приложение», разделён на
    решения, сделанное и оставшееся. Обещание «история с 5 до 50 бросков
    в Preferences» заменено фактом: 1500 записей в LittleFS.
    - firmware/README.m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
2026-09-19 chore(app): KSP и Room в сборке, совместимость с AGP 9.4 проверена
    Подготовка к задаче C2. KSP 2.2.10-2.0.2 (номер у KSP всегда склеен
    из версии Kotlin и своей) и Room 2.8.5 — последняя стабильная, ветка 2.x
    в режиме поддержки, Room 3.0 берём позже, когда устоится.
    Из коробки связка не собирается: KSP кладёт сгенерированный код
    в kotlin.sourceSets, а встроенный в AGP 9 компилятор Kotlin это
    запрещает — отдельного Kotlin Gradle Plugin в сборке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
2026-09-19 docs: решение о выгрузке схемы Room в JSON
    Схему выгружаем плагином androidx.room, файлы кладём в git: это нужно
    для миграций, когда таблицы начнут меняться. Вариант exportSchema=false
    отклонён. Подключим вместе с первой таблицей на шаге 2 задачи C2.
2026-09-19 feat(firmware): PIN, защита подключения и блокировка при подборе
2026-09-19 feat(app): вход по PIN, хранение и смена
    Задачи в плане не было: B5 значилась как работа только для прошивки.
    Но залитая защита кладёт приложение целиком — оно подключается, получает
    отказ на time и через десять секунд теряет связь, и так по кругу. Задача
    заведена как C5 и поставлена следом за B5.
    - Протокол: событие auth, поля pinset и authed в info, команды auth и pin.
    - При подключении шлём только info: до входа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
2026-09-19 fix(firmware): кости по кнопкам сортируются, повторы не принимаются
    Команда map принимала что угодно: таблица с двумя d4 сохранялась как есть,
    и кости шли в том порядке, в каком их прислали.
    - diceNormalize() сортирует таблицу по возрастанию вставками (значений
    восемь, городить сложнее незачем) и возвращает грань, встретившуюся
    дважды — отсюда внятный отказ с её номером.
    - То же правило применяет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
    [config.h, dice.h, wizards_staff.ino]
2026-09-19 fix(app): кнопка входа, неподвижная карточка, глазики в полях PIN
    Правки по итогам первой проверки входа по PIN.
    - Окно ввода PIN можно было закрыть, и вернуть его было нечем: метод
    showPinPrompt() написан, но ни к чему не привязан — мёртвый код.
    Теперь кнопка на карточке меняет смысл вместе с состоянием: посох
    закрыт — «Ввести PIN», вход открыт — «PIN» для смены. Заодно ушла
    вторая нелепость: до вх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
2026-09-19 feat(app): база бросков, подписи и догрузка истории
    Задачи C2 и C4. Лента переехала из памяти в базу Room, и туда же ложится
    то, что посох накопил без планшета.
    - Одна таблица rolls, ключ составной: (staffId, id). Ради этого B2 и шла
    раньше C2. Повторы отсеивает сама база вставкой с IGNORE — именно
    пропустить, а не перезаписать: у лежащей записи может быть подпись или
    пометка «не засчитан», и догрузка не д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
2026-09-19 feat(app): движок правил PF2e и лист Сильврина входными данными
    Первый кусок задачи D2. Экранов пока нет: только правила вывода и проверка,
    что они сходятся с бумажным листом.
    - rules/Pf2.kt: характеристики, степени владения, КБ с пределом ловкости,
    испытания, восприятие, навыки со штрафом брони, классовая СЛ, магия,
    атака и урон оружием, скорость. Чистые функции без единой зависимости
    от Android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
2026-09-20 feat(app): таблицы листа персонажа и Сильврин из бланка
    Шаги 1 и 2 задачи D2. Экранов пока нет: только хранение и засев.
    - Пять таблиц: characters плюс оружие, черты, снаряжение, заклинания.
    Версия базы 2, миграция создаёт их пустыми и rolls не трогает.
    - В базе только входные данные: КБ, классовую СЛ, восприятие и скорость
    считает движок. Вторая копия итогов разошлась бы с первой же правкой
    ловкос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
2026-09-20 feat(app): раздел «Персонажи» и вкладка «Обзор»
    Шаг 3а задачи D2. Лист показывается, выбор действия будет в шаге 4.
    - Чип-переключатель персонажа в верхней панели вместо колонки-списка:
    правка макетов от 19.09, на одного-двух персонажей список съедал бы
    треть экрана. Четыре вкладки, три пока объясняют, что в них будет.
    - «Обзор»: шапка, пять плиток защиты, шесть плиток характеристик,
    атаки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
2026-09-20 feat(app): лист персонажа с состоянием в бою
    Правки по замечаниям автора после первой примерки на планшете.
    - Порядок блоков: шапка, характеристики, жизнь, защита, атаки.
    Характеристики и здоровье наверху: туда смотрят чаще всего,
    а здоровье ещё и правят по нескольку раз за бой.
    - Уровень и героизм крупнее и с обводкой, у героизма кнопки:
    пункты ходят от нуля до трёх, больше правила не д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
2026-09-20 feat(app): блок жизни в листе персонажа
    Третий круг правок вида, автор утвердил. Дизайн правился без
    промежуточных коммитов, поэтому всё одним.
    - Уровень и героизм — справа от имени одним столбцом, уровень
    сверху. Кнопки героизма справа от его плитки, одна над другой,
    по пункту за нажатие: пунктов всего три.
    - Жизнь одной карточкой вместо четырёх плиток: ПЗ со шкалой,
    «Полностью здоро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
2026-09-21 feat(app): броня, испытания, сложности и атаки в листе персонажа
    - блок «КБ, доспех, навык, щит»: щит правится (ПЗ со шкалой, «поднят»,
    красный при поломке), доспех и владение показываются
    - ряд из пяти плиток испытаний: стойкость, реакция, воля, восприятие,
    инициатива; прибавку к инициативе даёт черта и хранит база
    - блок «Классовая СЛ, СЛ заклинаний, скорость, опыт»; опыт вводится
    руками,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
2026-09-21 feat(app): сохранение персонажа
    - кнопки «Сохранить» и «Загрузить» рядом с чипом персонажа
    - сохранение — копия листа со всеми частями в той же таблице:
    saveName, savedAt, saveOf, версия базы 9; запросы списков
    фильтруют по saveName IS NULL
    - имя по умолчанию «Имя ГГГГ-ММ-ДД ЧЧ:ММ:СС», занятое гасит кнопку
    - «Загрузить» сверяет лист со всеми сохранениями и предупреждает,
    если состояние не сохранено; даль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
2026-09-25 feat(app): справочник черт навыков и общих черт
2026-10-22 feat(app): справочник черт навыков и общих черт
    - сборщик tools/fetch_feats.py разбирает вкладки списка черт и берёт навыки черты в поле skills
    - ключ --saved: страницы только из сохранённых браузером файлов, без обращений к сайту
    - уже собранные черты не теряются, даже если их ссылок нет в текущем списке
    - в справочник добавлено 150 черт, всего 256; черты без легаси-версии не берутся
    - запись в журнале за 2026-0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
2026-10-22 docs(hardware): вся электроника получена, корпус без 3D-печати
    - в bom.md получены дисплей, PCF8574 ×2, выключатель и кнопки
    - SPEC, раздел 4: корпус из ПВХ-труб и фитингов, картридж без печати решается в задаче 14
    - запись в журнале за 2026-10-22
2026-10-22 docs(hardware): тумблер и кнопки проверены
    - выключатель — двухпозиционный тумблер, отверстие 6 мм
    - кнопки без фиксации, возвращаются сами
2026-10-22 feat(firmware): дисплей ST7789, экраны часов, взвода и результата
    - display.h: часы с датой, взвод «3d6», результат с барабаном как в приложении
    - строка состояния: время, значок связи с планшетом, батарея
    - режим SPI 3: в режимах 0–2 модуль без CS не отвечает
    - tools/display_test: перебор режимов SPI для подбора экрана
    - версия прошивки 0.6.1
2026-10-22 feat(firmware): дисплей ST7789, экраны часов, взвода и результата
    - результат броска через 5 минут без взвода сменяется часами
    - версия прошивки 0.6.2
    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
2026-10-22 feat(firmware): дисплей ST7789, экраны часов, взвода и результата
    - сумма во всю высоту экрана, шрифт впритык под наибольшую сумму броска
    - tools/display_test: переб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
2026-10-22 feat(firmware): барабан в узком окне и вспышка итога
    - барабан крутится в окне под самую широкую сумму броска, два кадра на смену
    - итог на миг вспыхивает крупнее и встаёт на место
    - размеры и позиции суммы как в 0.6.2, центровка по видимым точкам цифр
    - версия прошивки 0.6.5
2026-10-22 fix(firmware): однозначная сумма броска не показывалась
    - перенос строк шрифта выключен: в узком окне однозначная цифра уезжала за край
    - заряд аккумулятора числом рядом со значком батареи
    - версия прошивки 0.6.6
2026-10-25 docs(docs): служебные кнопки по варианту В и кнопки меню
    - служебные кнопки: Сброс, Повтор, Свет, Тихо; убрана «Экран»
    - четыре кнопки меню крестом: ОК, ◄, ►, Отмена; история листается стрелками
    - второй расширитель занят полностью, кнопок 16
    - время и дата из меню убраны, их ставит планшет
    - удача и неудача: крупно итог, снизу оба броска через запятую
2026-10-26 docs(hardware): служебные кнопки и меню, диод и гребёнка для шины земли
    - BOM: заказаны диод 1N4148 и гребёнка «папа» под шину земли кнопок
2026-10-26 feat(firmware): кнопки костей через PCF8574
    - buttons.h: поиск расширителей при старте, опрос по шине раз в 10 мс, дребезг 30 мс
    - кнопка кости взводит, та же кость добавляет ещё одну до 10, другая начинает заново
    - удар не считается 0,3 с после нажатия кнопки
    - взвод с кнопок и с планшета через общую armStaff
    - новый раздел журнала BUTTONS, расшифровка в приложении
    - версия 0.7.0
2026-10-26 fix(firmware): взвод кнопкой слетал сразу, счёт костей по кругу
    - таймаут взвода считается от свежего millis(): кнопка взводит позже начала
    оборота цикла, разность уходила через ноль, и взвод снимался в момент нажатия
    - после 10 костей следующее нажатие той же кнопки даёт снова одну
    - SPEC, раздел 2.2: счёт по кругу
    - журнал: расширители PCF8574 и первая кнопка кости
    - версия 0.7.3
2026-10-26 feat(firmware): пищалка, тики барабана и аккорды результата
    - sound.h: звук через LEDC, в тишине на ножке 8 гарантированно ноль
    - мигание светодиодом на ножке 8 убрано: та же ножка ведёт транзистор пищалки
    - писк при старте, щелчок на нажатие кнопки, тик на каждой смене числа
    - аккорд после броска, фанфара на 20 и грустный звук на 1 по d20
    - версия 0.8.0
2026-10-26 docs(hardware): схемы и распиновка приведены к собранному
    - INT расширителей не подключается: ножка 9 — кнопка BOOT
    - второй расширитель: 4 служебные кнопки и 4 кнопки меню, всего 16
    - диод 1N4148 поперёк зуммера, шина земли кнопок из гребёнки
    - чипы PCF8574T, подтяжки 1 кОм, модули цепочкой
    - питание: замеры MT3608, тумблер, грабля с отсечкой защиты TP4056
    - журнал: пищалка и звук
2026-10-27 docs(hardware): часы DS3231 в цепочке за расширителями
    - wiring.md: шина I2C цепочкой плата → PCF8574 №1 → №2 → часы, часы с выхода №2 по подписям
    - wiring.svg: блок I2C перерисован, вход и выход у расширителей, перемычки между модулями
    - ссылки на диод 1N4148 и гребёнку PLS-40 в BOM, , статус «получено 2026-10-26»
2026-10-27 docs(hardware): шины питания и земли, статусы BOM без дат
    - wiring.md: шины из гребёнки PLS-40: GND 30 (общая, вместе с кнопками), 5 В 7, 3,3 В 7
    - wiring.md, wiring.svg: земля кнопок на общую шину GND вместо двух гребёнок по 9 штырей
    - bom.md: статусы только «не заказано», «заказано», «получено»; гребёнка под три шины
2026-10-27 feat(firmware): кольцо WS2812B гасится при старте, огненная вспышка при включении
    - lights.h: кольцо гасится сразу в setup(), стартовая анимация огня около 1,8 с
    - потолок яркости кольца RING_BRIGHTNESS_MAX = 100: огонь тянет около 0,15 А
    - причина перезапуска в журнале при старте: отличить просадку питания от зависания
    - wiring.md: GPIO21 это TX UART0, вспышка кольца при включении от загрузчика
    - прошивка 0.9.0
2026-10-28 feat(firmware): вспышки кольца при итоге броска, новые звуки
    - кольцо: белая короткая вспышка на обычный бросок, золотая ровная на 20 и красная мерцающая на 1 по d20
    - вспышка стартует вместе с ростом суммы на экране и не блокирует посох
    - звук включения: писк POST 1 кГц
    - итог обычного броска: низкий «пуньк» вместо аккорда
    - 20 на d20: «вжух-блик», взмах клинка и мерцающий отблеск
    - 1 на d20: грустный тром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
2026-10-28 feat(firmware): тестовый режим d20 для проверки вспышек и звуков
    - TEST_D20_CYCLE в config.h: броски 1d20 по кругу случайный, 20, случайный, 1
    - предупреждение в журнале при старте и на каждую подмена
    - по умолчанию выключен
2026-10-28 feat(firmware): фраза из «The Sound of Silence» на провал вместо тромбона
    - 1 на d20: «Hello darkness, my old friend», шесть восьмых и целая нота с вибрато
    - красная вспышка кольца удлинена до 3,5 с под фразу
2026-10-28 feat(firmware): сон экрана через 2 минуты, взвод без срока
    - экран засыпает через 2 мин без действий, и взведённый тоже: гаснут подсветка и матрица
    - будят кость (сразу взвод), удар по взведённому посоху (сразу бросок), arm и roll с планшета
    - взвод больше не спадает через 5 мин, в info уходит arm: 0
    - результат возвращается к часам через 1,5 мин вместо 5
    - SPEC: решения автора от 2026-10-28
    - прошивка 0.12.0
2026-10-28 feat(firmware): опрос служебных кнопок и кнопок меню
    - второй расширитель 0x21: короткое нажатие при отпускании, долгое на 2-й секунде удержания
    - во сне любая служебная кнопка только будит экран, своё нажатие не выполняет
    - номера входов BTN_RESET … BTN_CANCEL в config.h
    - прошивка 0.13.0
2026-10-29 feat(firmware): кнопки Сброс, Повтор и Тихо
    - Сброс: снять взвод и вернуть часы, долгое нажатие гасит экран
    - Повтор: взвести последний бросок из истории во флеш, работает и после перезапуска
    - Тихо: звук вкл/выкл, помнится во флеш, значок перечёркнутого динамика в строке состояния
    - disarmStaff общая для кнопки и команды disarm
    - прошивка 0.14.0
2026-10-29 fix(firmware): щелчок кости при пробуждении экрана, заряд в журнале без спама
    - кость из сна: сначала будим экран, потом щёлкаем; наоборот щелчок пропадал
    - убрана временная отладка щелчка, попавшая в 5df6823
    - заряд в журнале при старте и при изменении на 5 %, а не каждые 10 с
    - прошивка 0.14.1
2026-10-29 feat(firmware): кнопка Свет, свечение кристалла огнём
    - три режима: выкл, тускло, ярко; долгое нажатие меняет палитру
    - пять палитр: красный - оранжевый, белый - жёлтый, тёмно- - светло-зелёный, голубой - синий, фиолетовый - тёмно-фиолетовый
    - свечение гаснет только кнопкой, сон экрана и взвод его не трогают
    - вспышки бросков поверх свечения, после них огонь разгорается снова
    - режим и палитра пом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
2026-10-29 fix(firmware): контрастные палитры свечения
    - яркость заложена в цвета палитры, а не общим множителем от накала: он съедал разницу у фиолетовой пары
    - голубой сдвинут к бирюзовому, тёмно-фиолетовый стал тёмным
    - накал огонька проходит весь путь от цвета к цвету
    - прошивка 0.15.1
2026-10-29 docs(hardware): кольцо без конденсатора 1000 мкФ
    - конденсатор у кольца выбивал защиту TP4056 при включении тумблера: посох не включался от аккумулятора
    - запасной вариант для длинных проводов: конденсатор через 470 Ом с диодом 1N4148
    - wiring.md, wiring.svg, SPEC 3.3 и 3.4, bom.md
2026-10-29 chore(firmware): проверка бита EOSC часов при старте
    - если бит EOSC взведён, часы стоят при питании от батарейки без флага потери питания
    - при старте бит сбрасывается, в журнал предупреждение
2026-10-29 feat(firmware): удача и неудача на долгий Повтор
    - долгое нажатие взводит 1d20 с удачей, следующее — с неудачей, по кругу
    - FORTUNE зелёным и MISFORTUNE красным на экране взвода, оба броска «14, 7» на результате
    - режим сбрасывается после броска; кнопка d20 и Сброс возвращают обычный бросок
    - протокол по плану D4: поле adv в roll, state, arm и roll; флаги в истории без смены формата
    - SPEC: решения автора от 2026-10-29
    - прошивк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
2026-10-29 feat(firmware): история бросков на посохе кнопками ◄ ►
    - 20 последних бросков из флеш, по 4 на экран, свежие сверху
    - строка: время, кость с отметкой удачи F или неудачи M, итог, под ним слагаемые
    - ◄ с любого экрана, выход ►, Отменой, Сбросом или через 1,5 мин; взвод не снимается
    - таймаут меню и истории 1,5 мин, как в SPEC
    - SPEC: решение автора от 2026-10-29
    - прошивка 0.17.0
2026-10-29 feat(firmware): выделение строки в истории, прокрутка по одной
    - выбранная строка на тёмно-синем фоне, ◄ ► двигают выделение по одной строке
    - список сдвигается вслед за выделением, а не страницами
    - строки перекрашиваются на месте, экран не мигает
    - прошивка 0.17.1
2026-10-29 docs: журнал сборки за 27–29 октября
    - шины питания, кольцо при старте
    - вспышки, звуки, сон экрана, служебные кнопки
    - свет, удача и неудача, история; щелчок из сна, конденсатор у кольца, отставание часов
2026-10-29 feat(firmware): меню на ОК: яркость, громкость, возврат к часам, сон, тест d20, сведения
    - settings.h: настройки ступенями во флеш, сон всегда дольше возврата к часам
    - menu.h: список и правка, значение сразу видно и слышно, ОК сохраняет, Отмена возвращает
    - недоступные ступени возврата и сна серые и пропускаются
    - тестовый режим d20 включается в меню, на взводе 1d20 пометка TEST
    - сведения: прошивка, заряд, бро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
2026-10-29 fix(firmware): испорченная таблица костей заменяется во флеш
    - таблица с повтором или мусором заменяется во флеш таблицей по умолчанию
    - предупреждение «кость d4 дважды» больше не повторяется при каждом старте
2026-10-29 feat(firmware): пометка TIME NOT SET на часах, пока время не с планшета
    - часы оранжевые и надпись TIME NOT SET под датой, если часы теряли питание
    - пометка пропадает сразу, как планшет присылает время
    - SPEC 2.4
    - прошивка 0.18.2
2026-10-29 feat(app): удача и неудача в ленте бросков
    - поле adv из события roll пишется в flags, миграция не нужна
    - оба броска через запятую, отброшенный зачёркнут, метка УДАЧА или НЕУДАЧА
    - крит по итогу, а не по первой кости: «20, 3» с неудачей не подсвечивается
    - старые записи с двумя значениями тоже через запятую
    - RollRecordTest
2026-10-29 feat(firmware): русский шрифт и все надписи экрана по-русски
    - font_ru.h: 66 русских букв 5×7, заглавные Ё и Й полной высоты, точки и кратка над клеткой
    - text.h: печать UTF-8 на экран и канву, ширина по знакам, полоса 2·size над строкой (G67)
    - экран проверки шрифта FONT_TEST (по умолчанию выключен)
    - все надписи посоха по-русски: взвод, часы, история, меню, сведения; «ID» и «3d6» латиницей
    - буферы строк с запасом вдвое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
2026-10-29 docs(repo): актуализировать README по состоянию проекта на октябрь 2026
2026-10-30 feat(firmware): пункт «Инструкция» в меню посоха
    - help.h: семь страниц инструкции (кости, удар, повтор, сброс, свет, кнопки меню, меню), до 8 строк по 19 знаков
    - седьмой пункт «Инструкция», ◄ ► листают страницы без круга, ОК и Отмена возвращают в список
    - шаг строк меню 23, окно прокрутки списка и стрелки ▲ ▼ при скрытых пунктах, ◄ ► по кругу
    - drawCenteredLine: заголовки истории и инструкции без мигания
    -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
2026-10-30 fix(app): кнопки PIN и «Логи» отдельной строкой под фактами
    - в одной строке с зарядом, состоянием и прошивкой кнопки не помещались, «Логи» обрезалась до «Л»
    - кнопки прижаты вправо, между ними малый зазор
2026-10-30 feat(firmware): help.h: восемь страниц инструкции (кости, удар, повтор, сброс, тихо, свет, кнопки меню, меню), до 8 строк по 19 знаков
2026-10-30 feat(app): экран «Инструкция» в разделе «Посох»
    - кнопка «Инструкция» рядом с PIN и «Логи», иконка «?» в круге
    - HelpScreen: карточки по костям, удару, каждой служебной кнопке, кнопкам и пунктам меню, часам и сну, связи с планшетом, питанию
    - тексты в HelpContent, сверены с прошивкой 0.21.0 и help.h
    - системная «Назад» закрывает инструкцию, открытый экран переживает поворот
    - HelpContentTest: у каждой кнопки посоха и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
2026-10-30 fix(firmware): опечатка «в верху» на странице «Тихо» инструкции
2026-10-30 fix(app): «Назад» и значок связи закрывают логи и инструкцию
    - системная «Назад» на экране «Логи» возвращает на «Посох», а не закрывает приложение
    - значок связи на рейке, как и пункты рейки, ведёт на сам экран «Посох», закрывая логи и инструкцию
2026-10-30 fix(app): PIN скрыт в журнале, русские строки по BLE не рвутся, PIN не уходит в резервную копию
    - свои команды auth и pin пишутся в журнал готовой строкой со «****», посоху уходит настоящая
    - набранная руками строка режется на команды так же, как посох, PIN прячется в каждой с запасом: одинарные кавычки, ключи без кавычек, \uXXXX; для исходящих строк есть запасная проверка по словам pin, old, new, auth
    - LineAssembler: ку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
2026-10-30 fix(firmware): история бросков не стирается и не портится молча
    - LittleFS форматируется сам только на чистой плате: нет отметки fsready, номер бросков 0 и раздел пуст; иначе посох работает без истории во флеш, ERROR в журнале, histok в info
    - наличие файла истории подтверждают и список каталога, и открытие; новый файл пишется как /rolls.new, рабочий /rolls.bin не обрезается
    - формат записи 2: CRC-16 в бывших байтах вырав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
2026-10-30 feat(app): histend с err — журнал говорит о неполной догрузке истории
